sebastian-silaghi/Analog-Interface-for-ADC-input/Documentation/Documentation.pdf

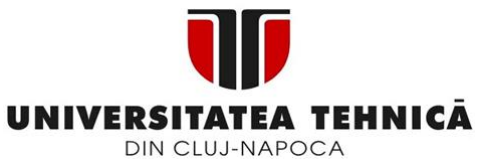
[picture p1: figure]

# SYSTEMS WITH ANALOG INTEGRATED CIRCUITS PROJECT

# ANALOG INTERFACE

## Professor: Alessandro Battigelli

## Student: Silaghi Sebastian

## Year: III

## Specialization: Applied Electronics

## TABLE OF CONTENT

## 1. Project theme

Design of an analog interface consisting of four cascaded stages: instrumentation amplifier made with three operational amplifiers with differential voltage input and voltage output (stage 1), an analog Tow-Thomas filter with voltage input and voltage output (stage 2), an amplifier with programmable gain (stage 3) and a precision double-alternating rectifier (stage 4).

The differential input signal is the voltage signal given by a sensor with amplitude in the range [261mV; 520mV], and the maximum frequency of the signal is considered the center frequency of the band-pass filter in the Tow-Thomas filter.

Stage 1 - Instrumentation amplifier: linear gain 6 [V/V] with adjustment of the DC voltage at the output. The stage band should be higher than the maximum frequency of the input signal and the output signal should be undistorted.

Stage 2 - Analog Tow-Thomas filter: unity gain in the passband, minimum input impedance 1kΩ and quality factor 1. The center frequency of the bandpass filter and the Tow-Thomas filter band have the same frequency of 7kHz. The signal at the output of the filter should be undistorted.

Stage 3 - The programmable gain amplifier (PGA) operates as an inverting amplifier with switches outside the signal path for gain adjustment. The minimum gain of the stage is 1dB, and the maximum gain is 7dB with a resolution of 2dB in four steps. The minimum input impedance should be 1.5kΩ, and the output signal should be undistorted at the maximum frequency for both the minimum input amplitude and maximum gain of the stage, and for the maximum input amplitude and minimum gain of the stage.

Stage 4 – Double-phase precision rectifier: unity gain and it is desired to perform its function correctly at large signal.

For the design, the ADA4627 operational amplifier and the ADG1311 integrated circuit for switches were used.

## 2. Stages sizing

### 2.1 Stage 1 sizing

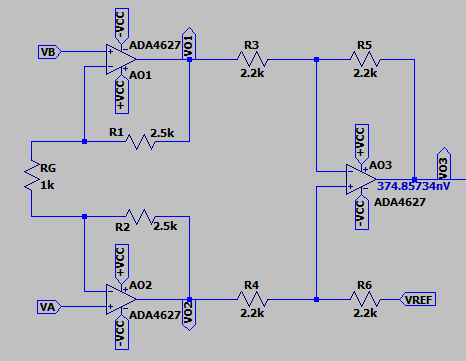
[picture p2: figure]

Figure 1. Instrumentation amplifier

This stage consists of 2 substages, each with a separate gain: AO1 and AO2 form the first substage with gain A1, and AO3 forms the second substage with gain A2.

For the first substage, both operational amplifiers AO1 and AO2 have negative feedback, therefore we have:

v1

+ = v1
− = vB
v2

+ = v2
− = vA

⇒ iRG =

vA−vB
RG

Also,
v02 − v01 = vR2 + vRG + vR1

v02 − v01 = iRG ⋅ R2 + iRG ⋅ RG + iRG ⋅ R1

R1 = R2 ⇒ v02 − v01 = iRG ⋅ (2R1 + RG

) (1)

Replacing iRG in relation (1) we get:

v02 − v01 = (1 +

2R1
RG

) (vA − vB)

So, we obtain the gain of the first substage A1= (1 +

2R1
RG

)

For the second substage, we use Millman`s theorem to find the potentials v3

+ and v 3
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
VREF
R6
1
R4

+

1
R6

AO3 also has negative feedback, thus:
v3

+ = v3
− and we consider R3 = R4 și R5= R6 then we get:

v03 =

R5
R3

### (v02 − v01) + VREF (2)

So, we obtain the gain of the second substage A2=

R5
R3

Replacing realtion (1) in (2) we have: v03 =

R5
R3

(1 +

2R1
RG ) (vA − vB) + VREF

The linear gain A of the entire stage will be the product of the individual gains of the two substages, which must be 6 V/V. We want the first substage to be the gain stage, and the second to be the differential stage with unity gain, therefore:

A = A1 ⋅ A2 = 6 ⇒

A1 = 6 [

V
V

]

A2 = 1 [

V
V

]

A2 = 1 ⇒

R5
R3

= 1 ⇒ R5 = R3

R3 = 2.2kΩ ⇒ R5 = 2.2kΩ

A1 = 6 ⇒

1 +

2R1
RG

= 6 ⇒ R1 =

5
2

RG

RG = 1kΩ ⇒ R5 = 2.5kΩ

From .op analysis ⇒ v03 = Vos= 585µV ⇒ VREF we set it to 585µV for the output DC offset voltage adjustment. In figure 1 that voltage of 375nV represents the offset voltage after compensation.

### 2.2 Stage 2 sizing

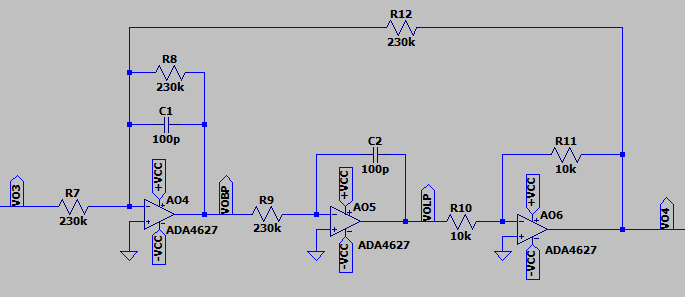
[picture p3: figure]

Figure 2. Tow-Thomas filter

Transfer function general form: H(s) = H0

ωp

2

s

2+s⋅

ωp
Q

+ωp

2

Bandpass gain: H0 =

R12
R7

Cutoff angular frequency: ωp =

1
√R9R12C1C2

Quality factor: Q = R8√
C1
C2

⋅

1
R9R12

H0 = 1 ⇒ R12 = R7 (3)

For calculation simplicity, we consider R12 = R9 (4) and C1 = C2 (5) and we get:

wp =

1
R9C1
(6) , Q =

R8
R9

(7)

Q = 1 ⇒ from (7) that R8 = R9
(8)

From (6) ⇒ the cutoff frequency of the filter is fp =

1
2πR9C1

Also, fp = BW ⋅ Q , where BW is the band of the filter, and we get the equality:

1
2πR9C1

= BW ⋅ Q

We know that BW = 7kHz and Q = 1 ⇒

1
2πR9C1

= 7kHz ⇒ R9C1 = 23 ⋅ 10⁻⁶

We choose C1= 100pF ⇒ R9 = 230kΩ and according to (4), (5), (8) and (3) ⇒ R12 = 230kΩ , C2= 100pF, R8 = 230kΩ, respectively R7 = 230kΩ

We want the inverting amplifier AO6 to have unity gain in order to maintain the total gain of the filter to 1. The gain of the amplifier AO6 is |A| =

R11
R10

|A| = 1 ⇒ R11 = R10

Let R11 = 10kΩ ⇒ R10 = 10kΩ

### 2.3 Stage 3 sizing

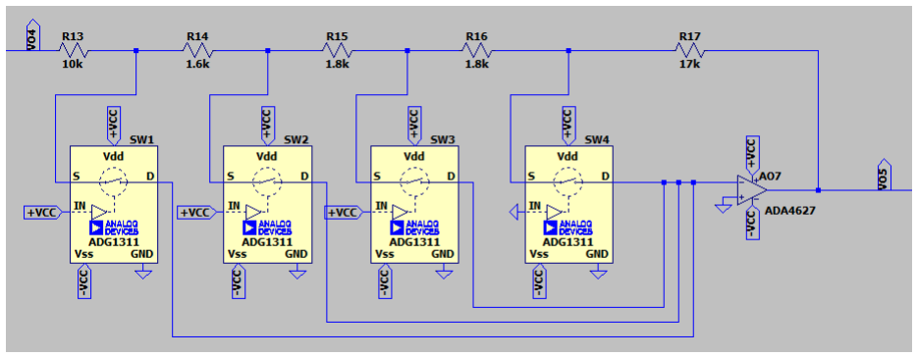
[picture p4: figure]

Figure 3. Programmable gain amplifier (PGA)

This PGA can generate 4 different gains (A1, A2, A3, A4) from 1dB to 7dB, in four steps,

so we have a 2dB step between each gain, where the overall gain is|A| =

RF
RG

|A1

| = 1 dB = 1.12 V/V

|A2

| = 3 dB = 1.41 V/V

|A3

| = 5 dB = 1.78 V/V

|A4

| = 7 dB = 2.24 V/V

The switches made with the ADG1311 integrated circuit operate in complementary logic, so a switch will be active if a logic 0 (GND) is applied to the IN terminal and will be inactive if a logic 1 (+VCC) is applied to the IN terminal.

SW1 | SW2 | SW3 | SW4 | RF | RG | |A|
0 | 1 | 1 | 1 | R17 + R16 + R15 + R14 | R13 | A4
1 | 0 | 1 | 1 | R17 + R16 + R15 | R13 + R14 | A3
1 | 1 | 0 | 1 | R17 + R16 | R13 + R14 + R15 | A2
1 | 1 | 1 | 0 | R17 | R13 + R14 + R15 + R16 | A1

R17
R13 + R14 + R15 + R16

= 1.12 (9)

R16 + R17
R13 + R14 + R15

= 1.41 (10)

R15 + R16 + R17
R13 + R14

= 1.78 (11)

R14 + R15 + R16 + R17
R13

= 2.24 (12)

(12) – (11) ⇒ R14 = 0.16R13 (13)
(11) – (10) ⇒ R15 = 0.18R13 (14)
(10) – (9) ⇒ R16 = 0.18R13 (15)

From (9), (13), (14), (15) ⇒ R17 = 1.7R13 (16)

Let R13 = 10kΩ . From (13), (14), (15), (16)

R17 = 17kΩ

R16 = 1.8kΩ

R15 = 1.8kΩ

R14 = 1.6kΩ

### 2.4. Stage 4 sizing

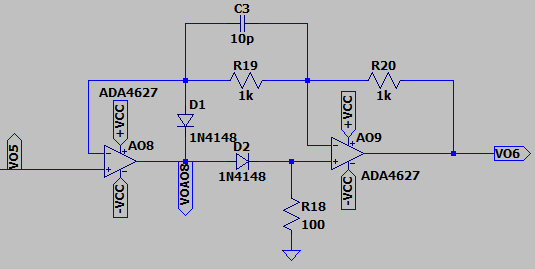
[picture p5: figure]

Figure 4. Precision positive full-wave rectifier

We assume for both cases I and II that the two diodes D1 and D2 are OFF. We will consider
vin = vO5 and vout = vO6

I. vin < 0

v8

+ = vin < 0
v9
+ = 0 | ⇒ v8 +
- v8

− < 0 ⇒ VoAO8 ↘ -Vcc

NF at AO9 ⇒ v9

+ = v9
− = 0 ⇒ v8

− = 0

VA1 = 0 | ⇒ D1 ON

VK1 = VoAO8 = −Vcc

VA2 = VoAO8 = −Vcc ⇒ D2 OFF

VK2 = 0

For this case when vin < 0, the diodes are actually D1 ON and D2 OFF, not as we initially assumed. Next, we analyze the circuit in this configuration. We consider the diode in conduction as a voltage source of 0.7V.

v8

+ = vin < 0

v8

− = vD + VoAO8

NF at AO8 ⇒ v8

+= v8
− (17) ⇒ vin = vD + VoAO8 ⇒ VoAO8 = vin − vD

v9

+ = 0

v9

− =

v8

−
R19

+

vout
R20
1
R19

+

1
R20

NF at AO9 ⇒ v9

+ = v9
− ⇒

v8

−

R19

+

vout
R20

= 0 ⇒ vout = −

R20
R19

vin

II. vin > 0

v8

+ = vin > 0 ⇒ v8 + − v8
− > 0 ⇒ VoAO8 ↗ +Vcc
v8

− = 0

VA1 = 0 | ⇒ D1 OFF

VK1 = VoAO8 = +Vcc

VA2 = VoAO8 = +Vcc ⇒ D2 ON

VK2 = 0

For this case when vin < 0, the diodes are actually D1 OFF and D2 ON, not as we initially assumed. Next, we analyze the circuit in this configuration. We consider the diode in conduction as a voltage source of 0.7V.

v8

+ = vin

v9

+ = VoAO8 − vD (18)

v9

− =

v8

−
R19

+

vout
R20
1
R19

+

1
R20

(19)

NF at AO9 ⇒ v9

+ = v9
− (20) ⇒ NF at AO8 through AO9 ⇒ v8

+ = v8
− = vin (21) (voltage
follower) ⇒ v9

+ = vin (22)

From (18), (22) ⇒ vin = VoAO8 − vD ⇒ VoAO8 = vin + vD

From (19), (21), (22) ⇒ vin =

vin
R19

+

vout
R20
1
R19

+

1
R20

⇒ vout = vvin

Concl.: vout = | vin ∈ [vD + VoAO8

, VoAO8 − vD]

The gain

R20
R19

for negative alternation of the input signal must be 1, therefore

R20 = R19. IF we let R20 = 1kΩ ⇒ R19 = 1kΩ.

Resistor R18 influences the rectified output voltage swing on the positive alternation. According to the amplifier datasheet, for a 100Ω load, the output voltage swing V_oAO8_high is +Vcc-1.3V, and V_oAO8_low is -Vcc+1.3V . In this stage configuration, if R18 is 100Ω, the rectifier output oscillates. The more the resistance R18 decreases, the more the oscillations are damped, but already below 60Ω we do not get a good output voltage swing, and the rectification on the positive alternation is limited below the amplitude of the input signal. Thus, a possible solution would be a frequency compensation using a capacitor on the feedback of AO8 to move the parasitic poles that create oscillations further in frequency. The load remains at 100Ω and the capacitor C3 is 10pF. The value of C3 is experimentally chosen so that the rectification is correct without oscillations in the transient simulation.

In order to keep the output voltage of AO8 out of saturation, vin + vD when vin > 0, respectively vin − vD when vin < 0 must not exceed the output voltage swing VoAO8_high, respectiv VoAO8_low.

−

R20
R19
vin | dacă vin < 0
vin | dacă vin > 0

## 3. Circuit simulations

### 3.1 Stage 1 simulations

### 3.1.1 DCOP simulation

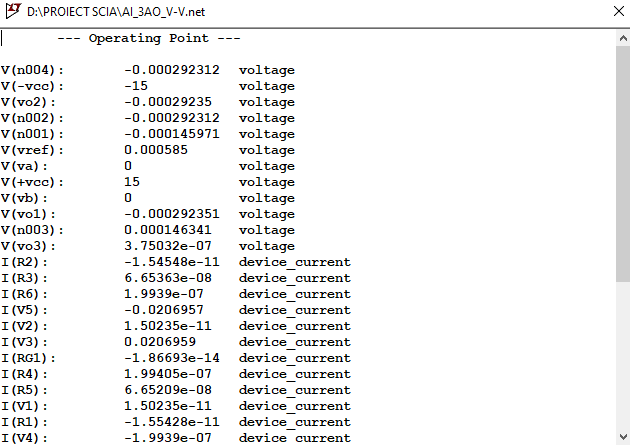
[picture p6: figure]

Figure 5. DC operating point

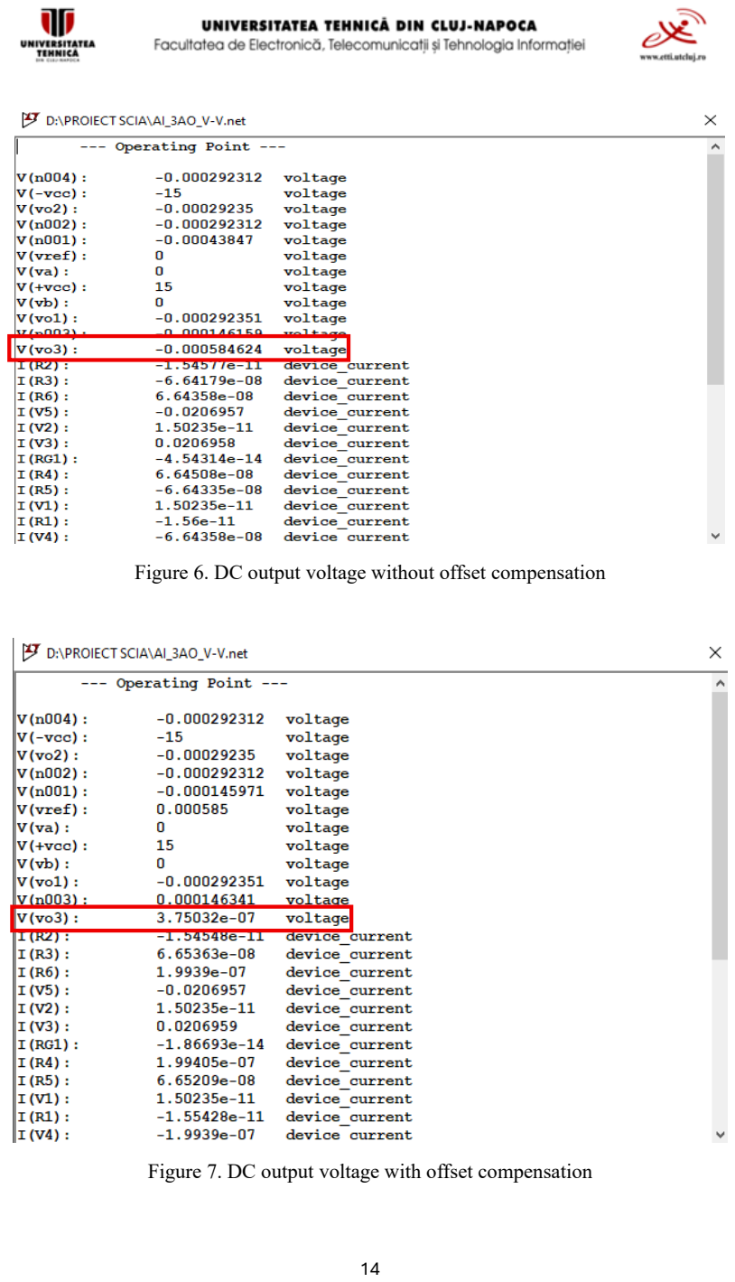
[picture p7: page 14]

Figure 6. DC output voltage without offset compensation

Figure 7. DC output voltage with offset compensation

### 3.1.2 AC simulations

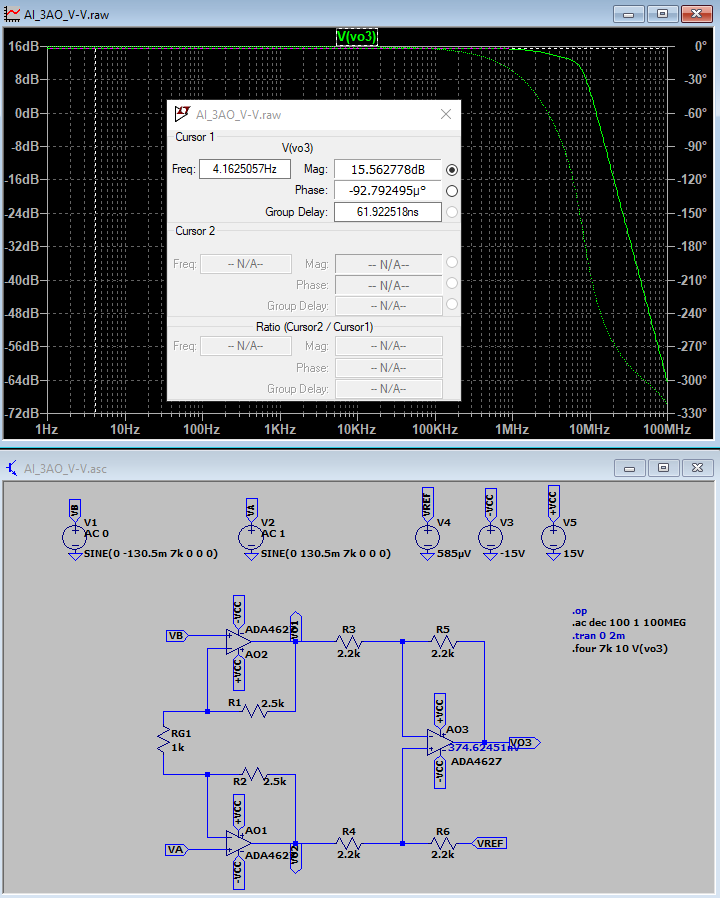
[picture p8: figure]

Figure 8. Low frequency gain

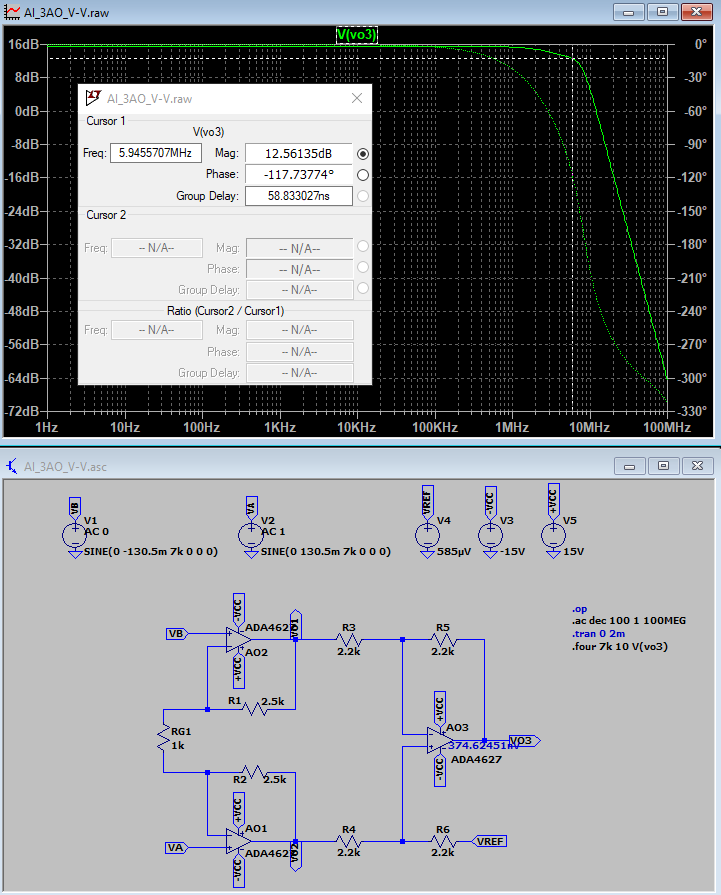
[picture p9: figure]

Figure 9. Band at -3dB

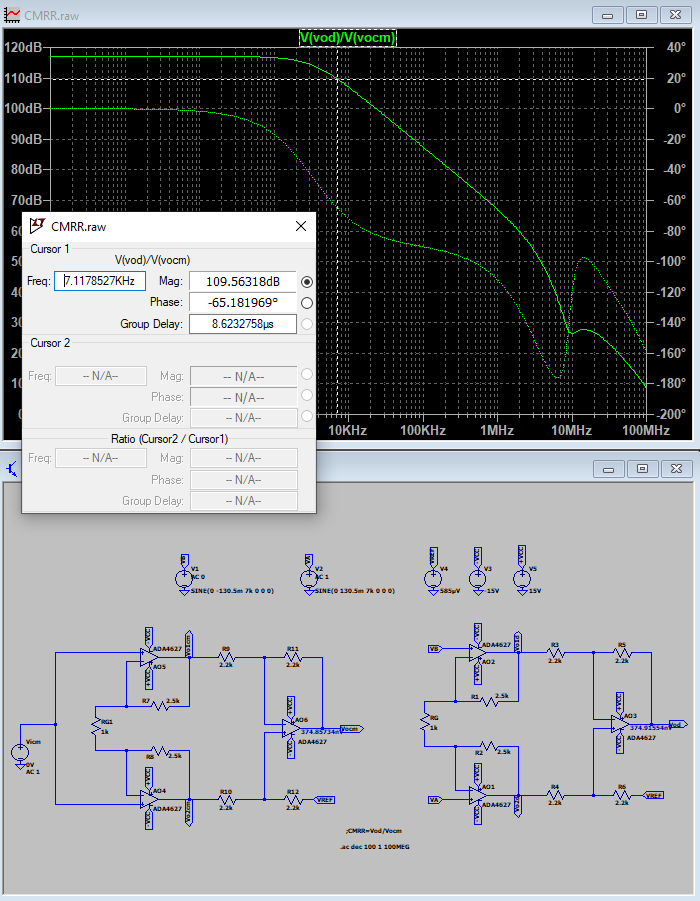
[picture p10: figure]

Figure 10. CMRR

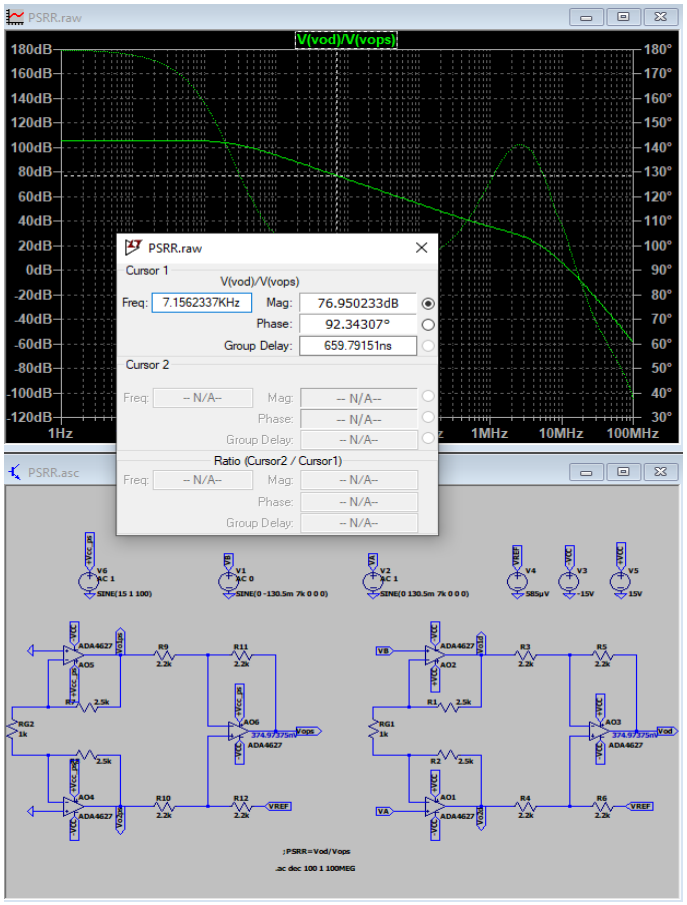
[picture p11: figure]

Figure 11. PSRR

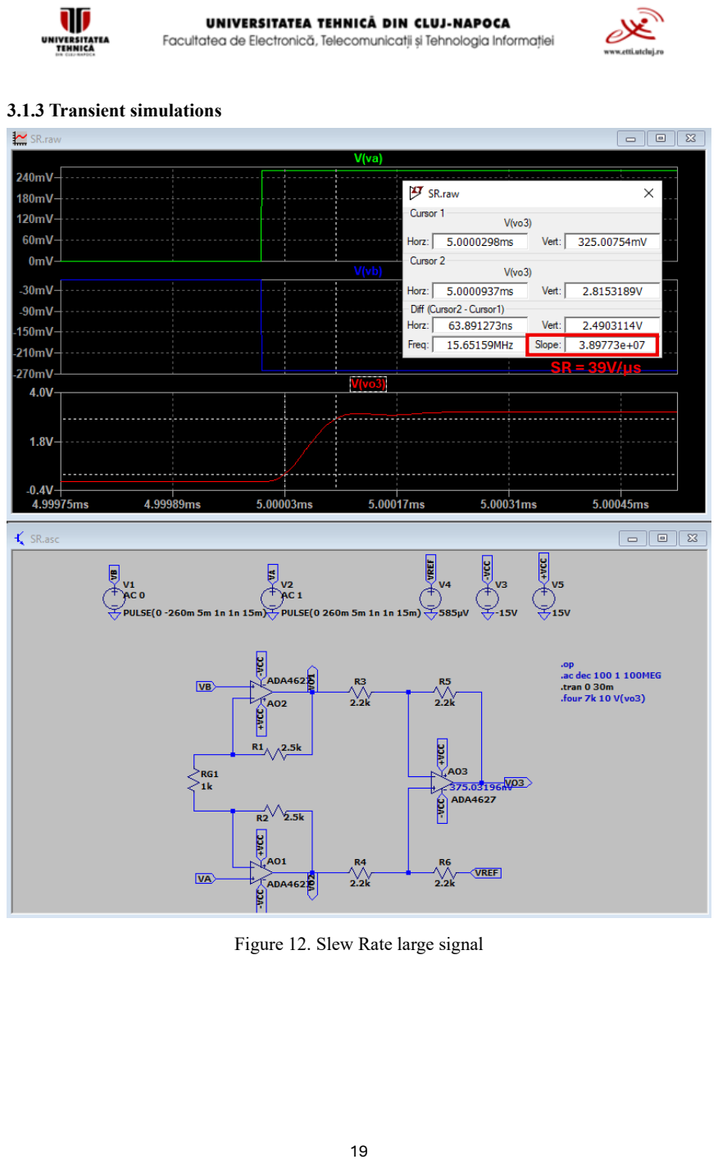
[picture p12: page 19]

### 3.1.3 Transient simulations

Figure 12. Slew Rate large signal

### SR = 39V/µs

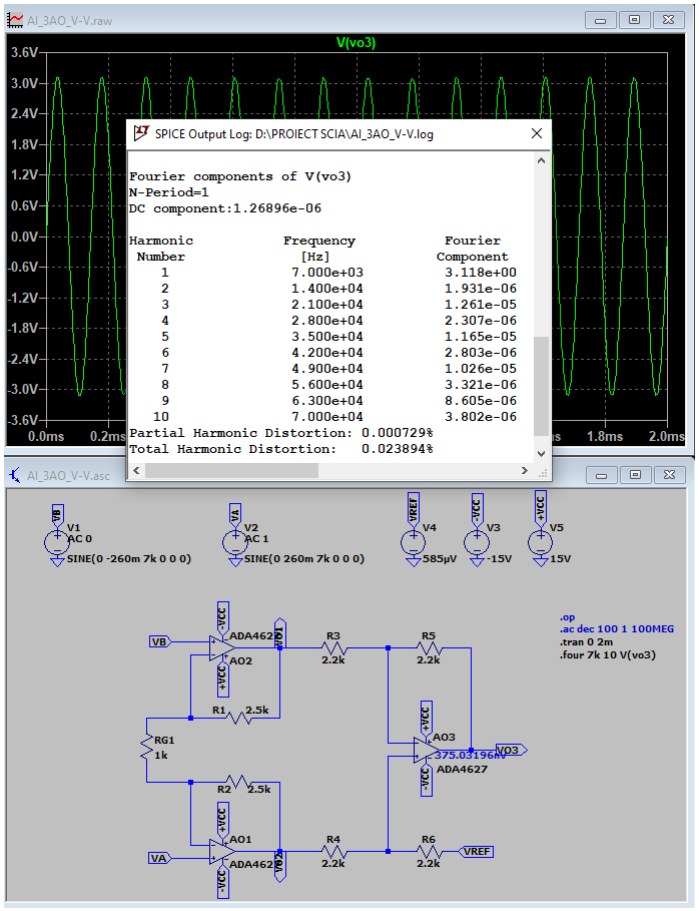
[picture p13: figure]

Figure 13. THD large signal

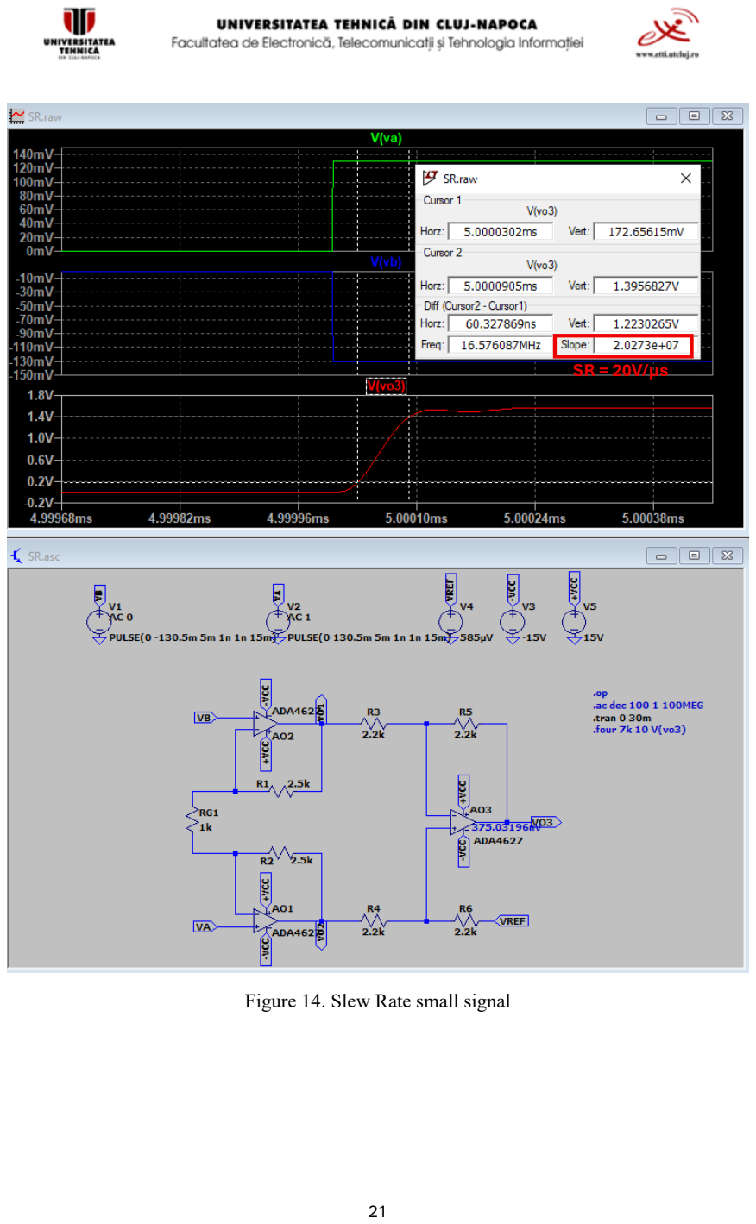
[picture p14: page 21]

Figure 14. Slew Rate small signal

### SR = 20V/µs

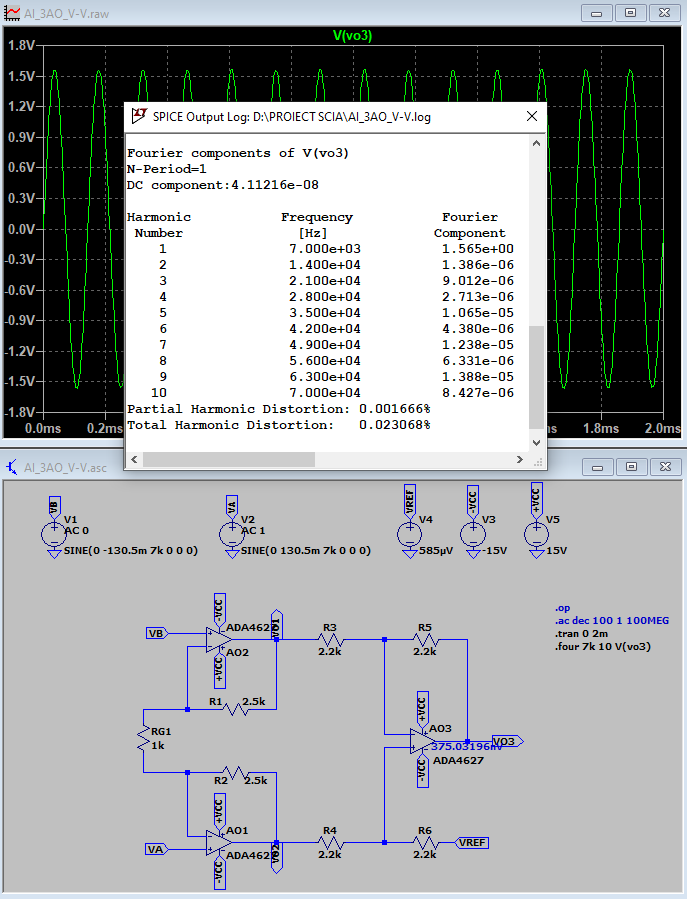
[picture p15: figure]

Figure 15. THD small signal

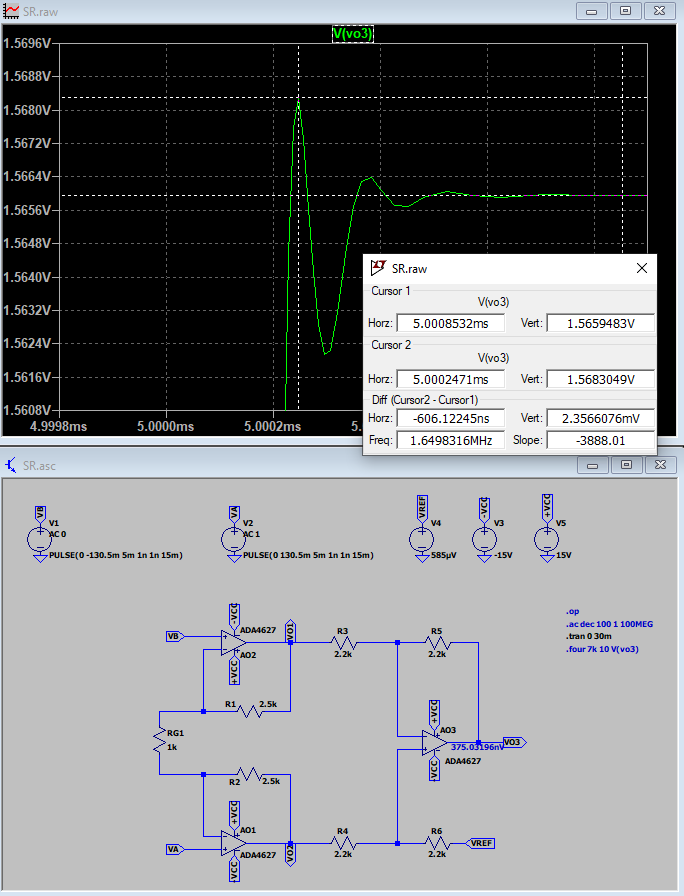
[picture p16: figure]

Figure 16. Small step response

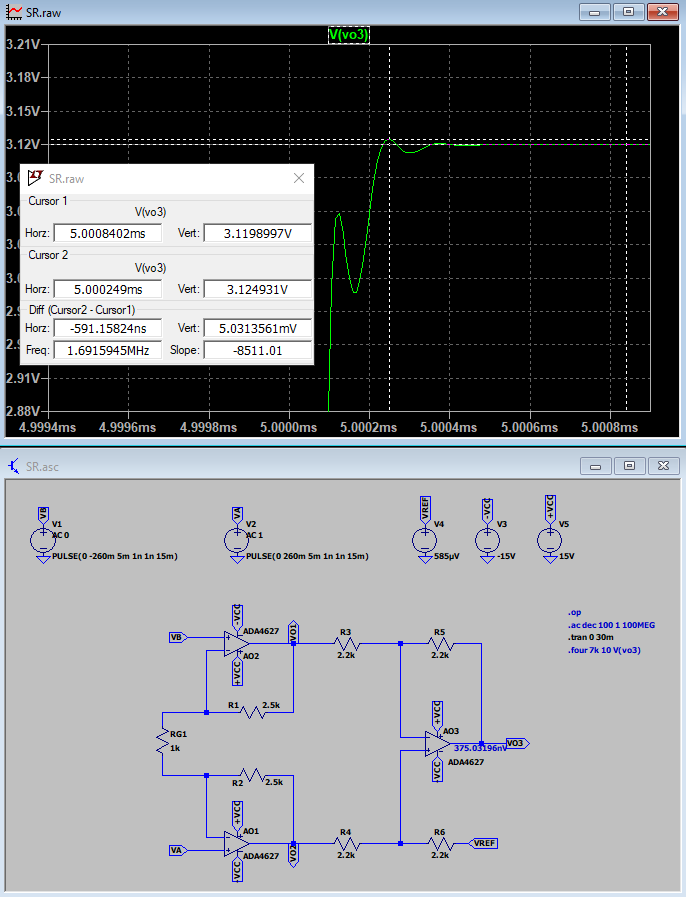
[picture p17: figure]

Figure 17. Large step response

### 3.2 Stage 2 simulations

### 3.2.1 DCOP simulations

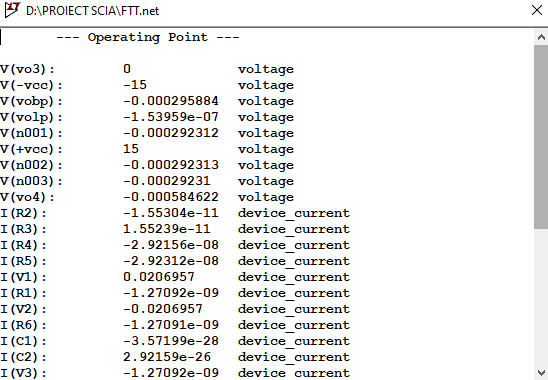
[picture p18: figure]

Figure 18. DC operating point

### 3.2.2 AC simulations

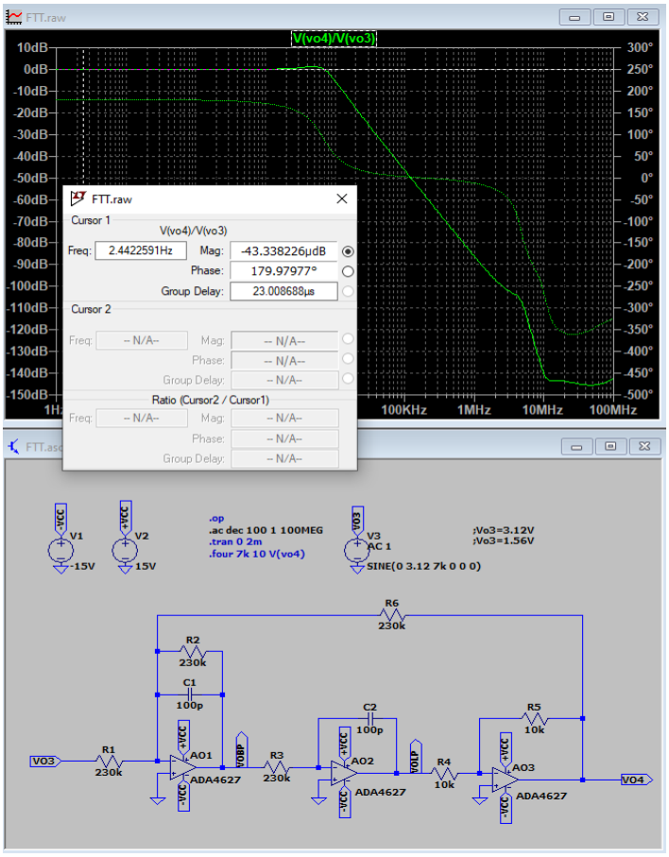
[picture p19: figure]

Figure 19. Filter gain

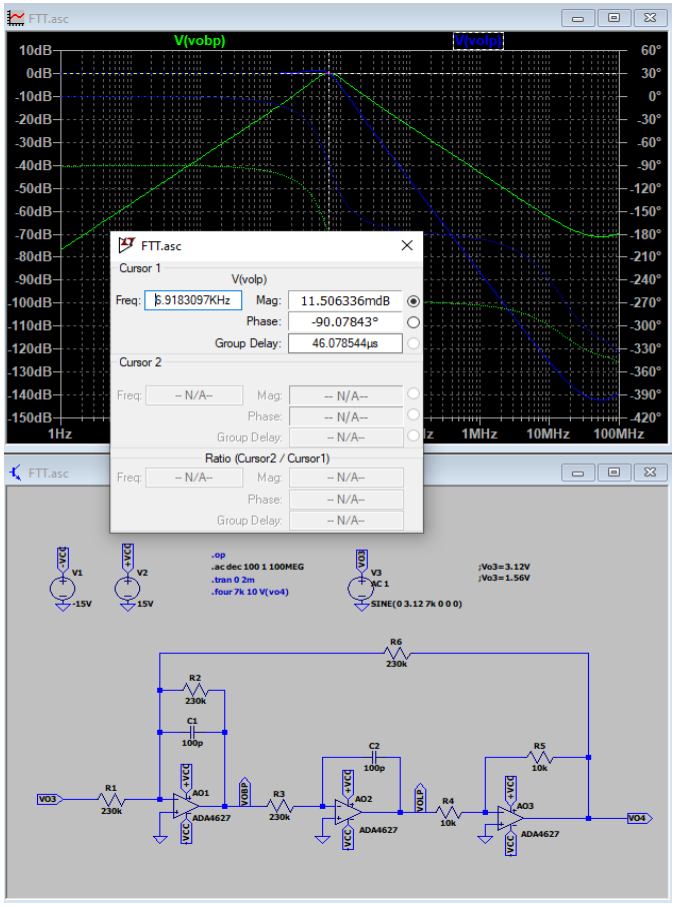
[picture p20: figure]

Figure 20. Filter band and bandpass gain (-90deg LPF)

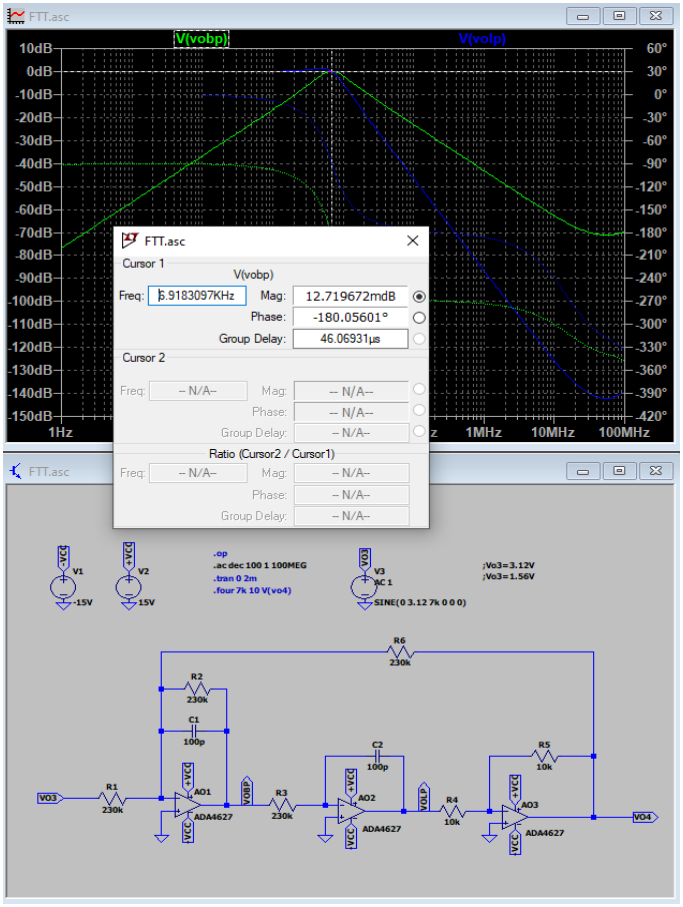
[picture p21: figure]

Figure 21. Filter band and bandpass gain (-180deg BPF)

### 3.2.3 Transient simulations

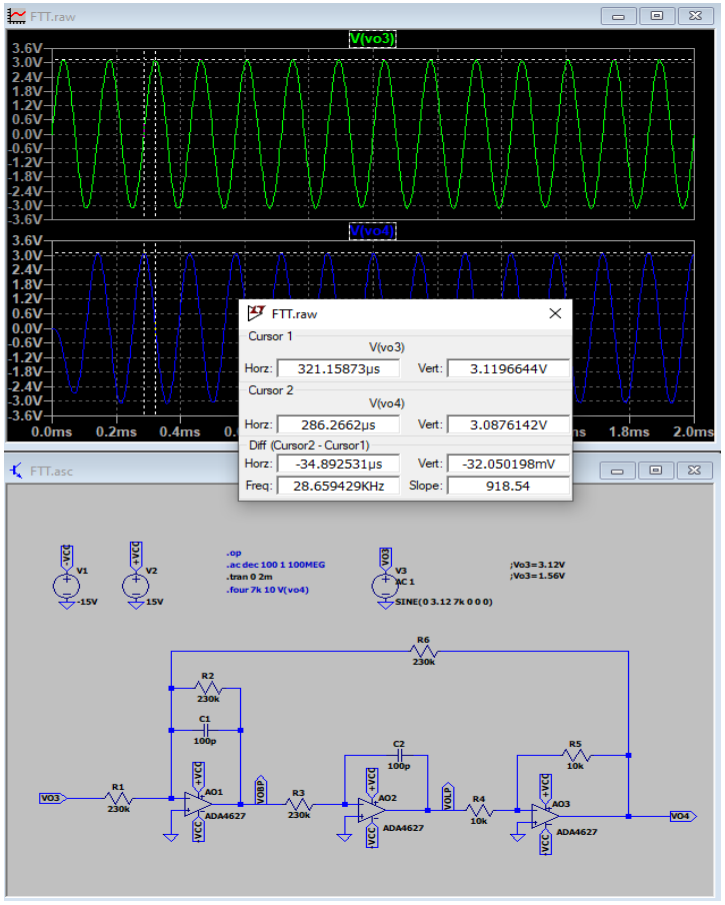
[picture p22: figure]

Figure 22. Large signal linearity (v̂04 = H0 ⋅ v̂03 at fmax = 7kHz)

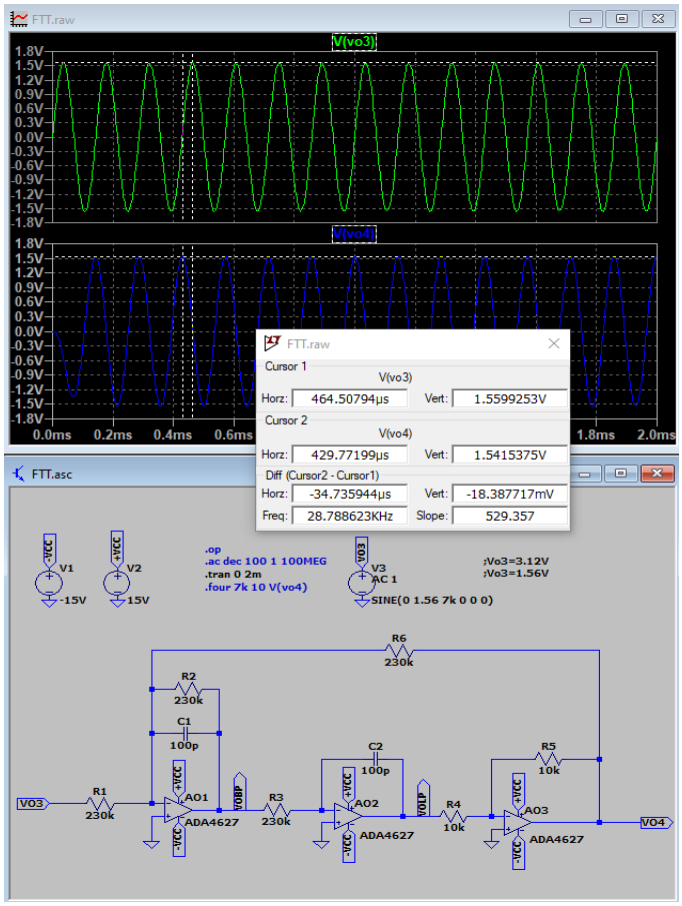
[picture p23: figure]

Figure 23. Small signal linearity (v̂04 = H0 ⋅ v̂03 at fmax = 7kHz)

### 3.3 Stage 3 simulations

### 3.3.1 DCOP simulations

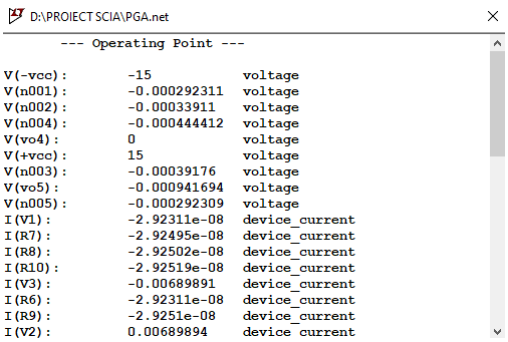
[picture p24: figure]

Figure 24. DC operating point

### 3.3.2 AC simulations

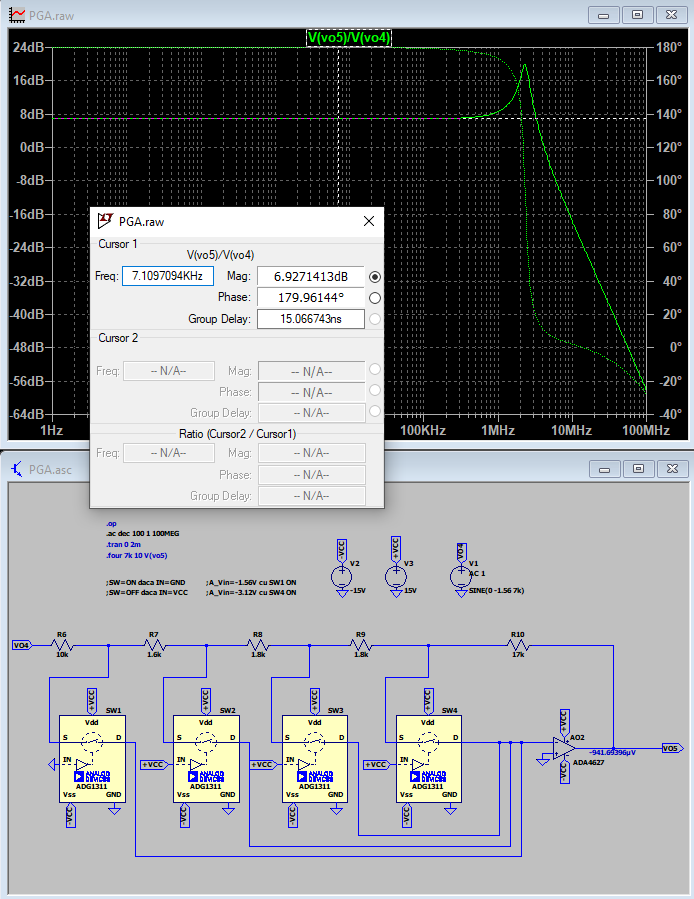
[picture p25: figure]

Figure 25. 7dB gain

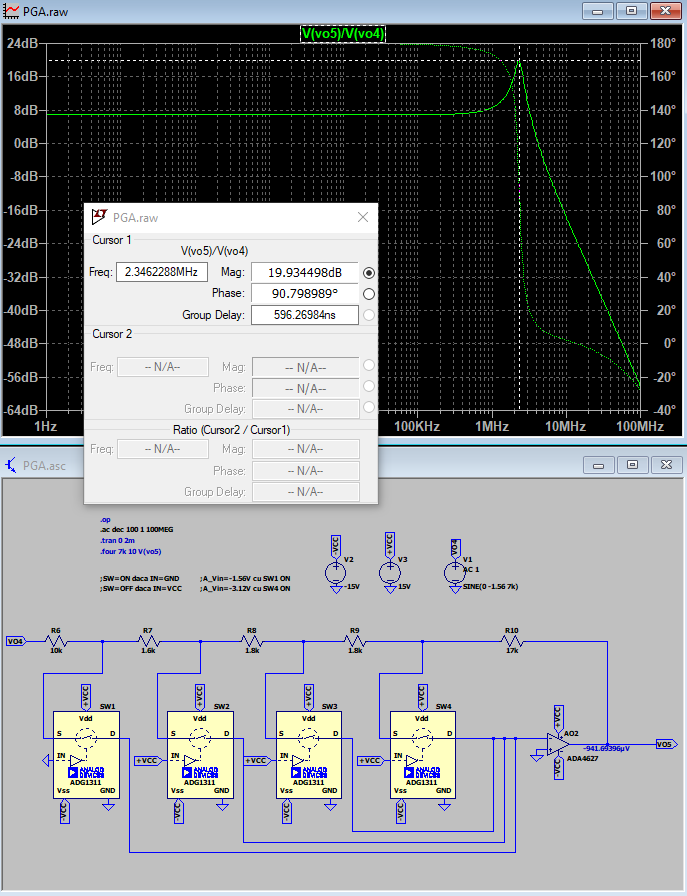
[picture p26: figure]

Figure 26. Bandwidth for 7dB gain

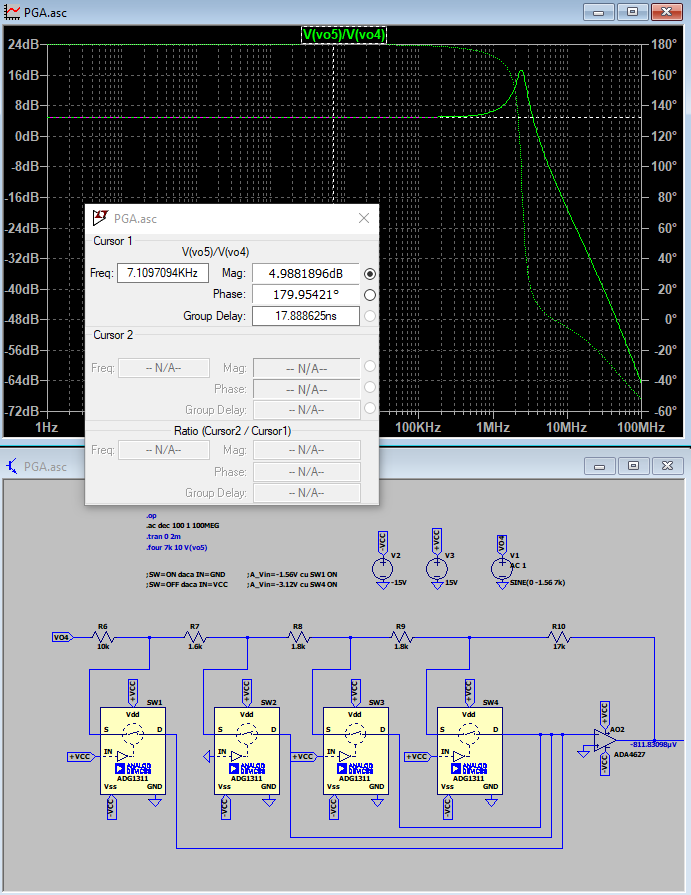
[picture p27: figure]

Figure 27. 5dB gain

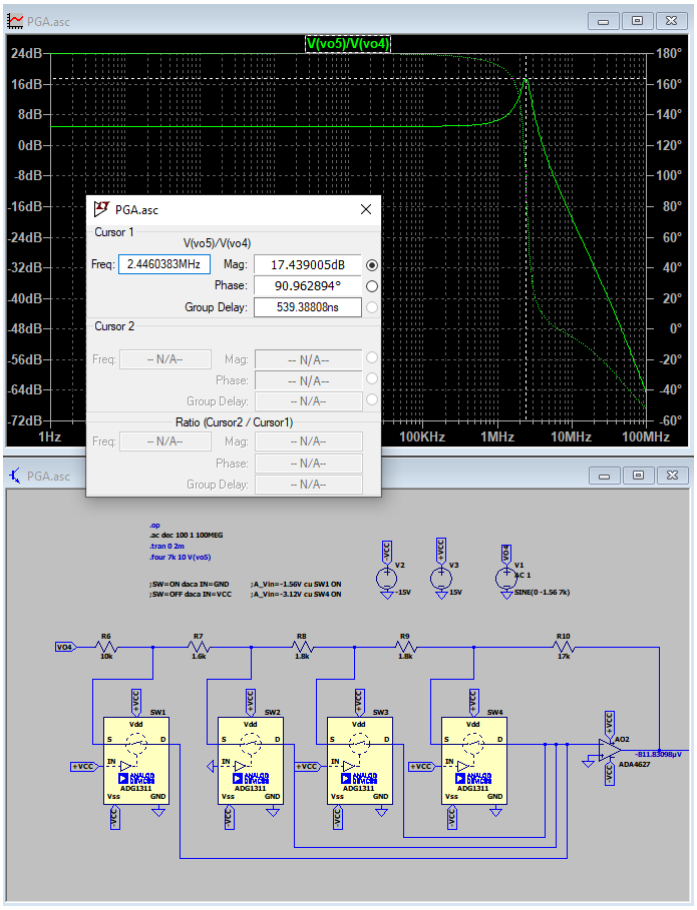
[picture p28: figure]

Figure 28. Bandwidth for 5dB gain

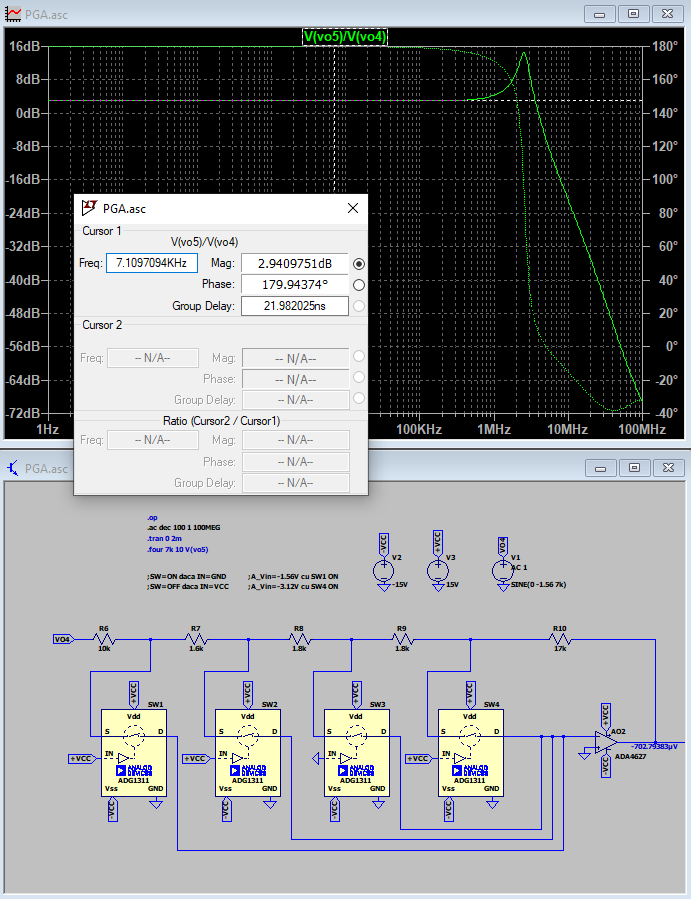
[picture p29: figure]

Figure 29. 3dB gain

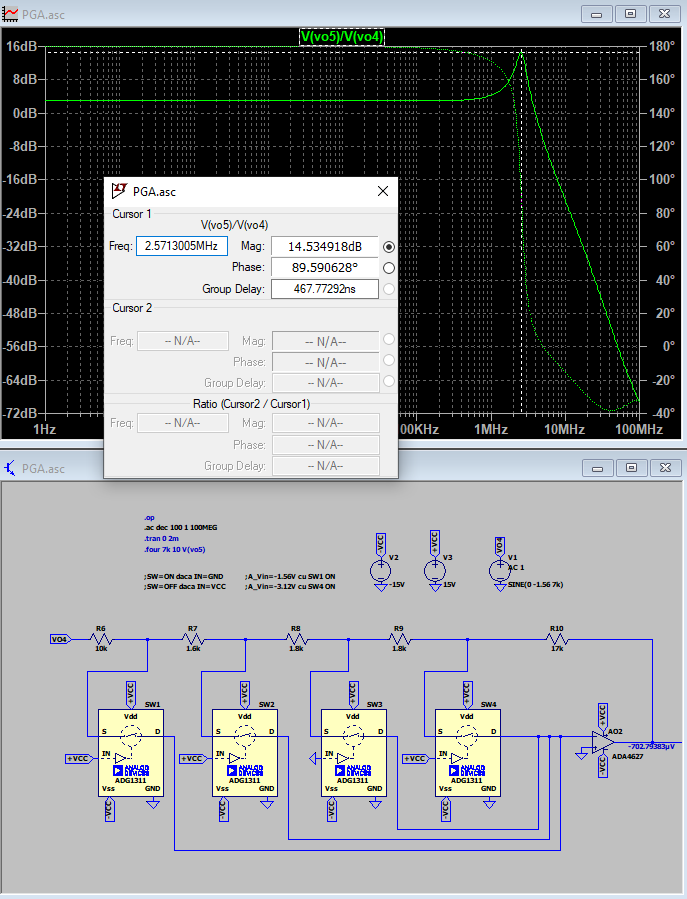
[picture p30: figure]

Figure 30. Bandwidth for 3dB gain

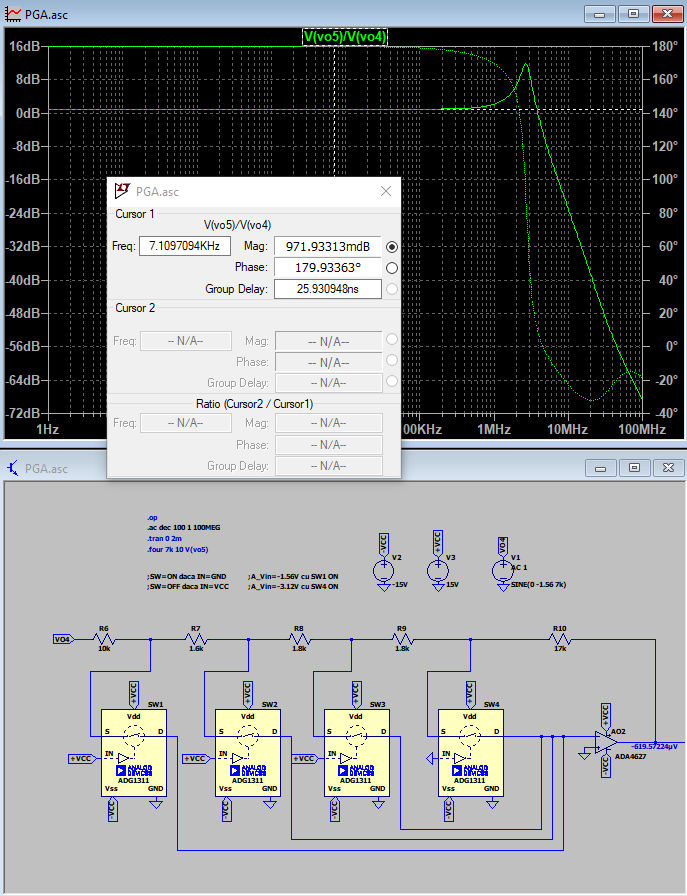
[picture p31: figure]

Figure 31. 1dB gain

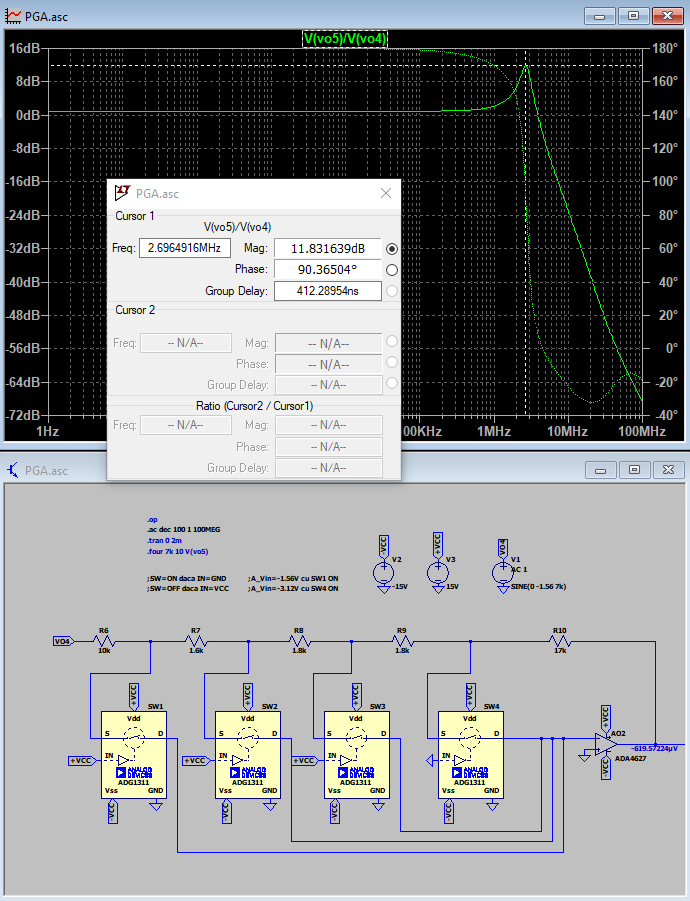
[picture p32: figure]

Figure 32. Bandwidth for 1dB gain

### 3.3.3 Transient simulations

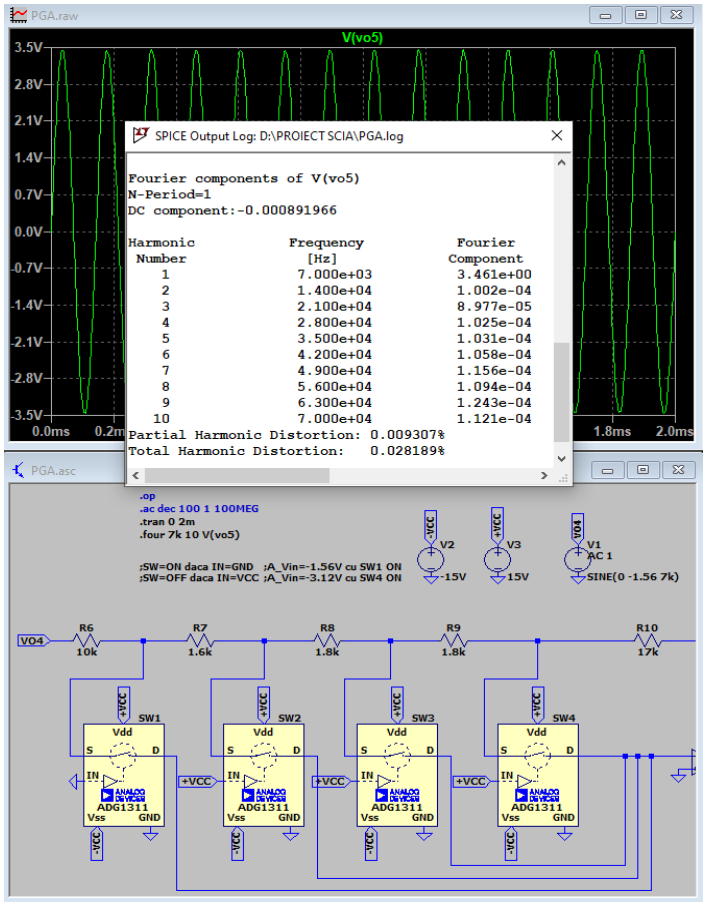
[picture p33: figure]

Figure 33. THD (small signal and maximum PGA gain)

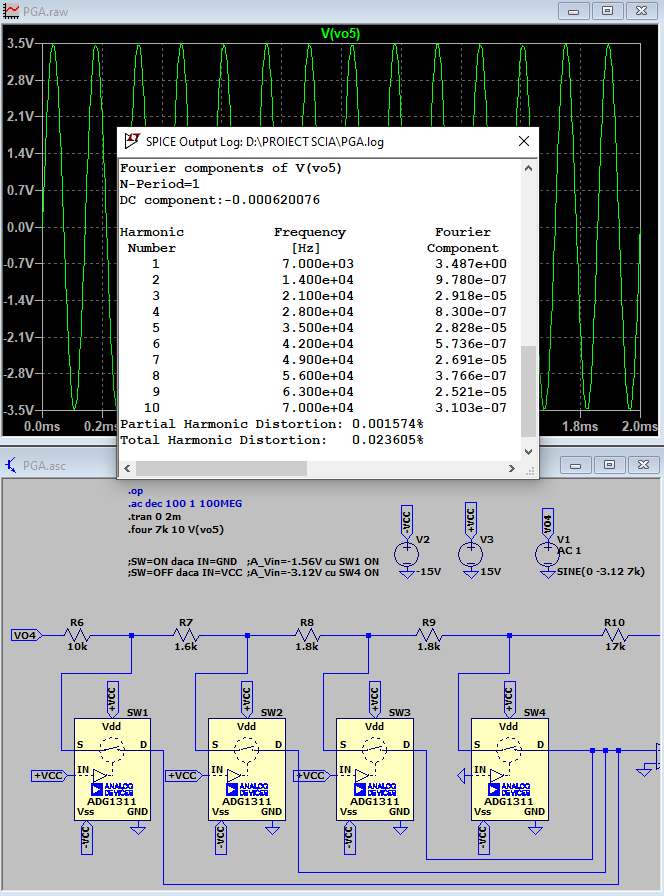
[picture p34: figure]

Figure 34. THD (large signal and minimum PGA gain)

### 3.4 Stage 4 simulations

### 3.4.1 DCOP simulations

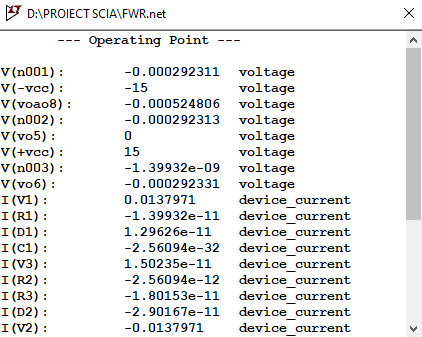
[picture p35: figure]

Figure 35. DC operating point

### 3.4.2 Transient simulations

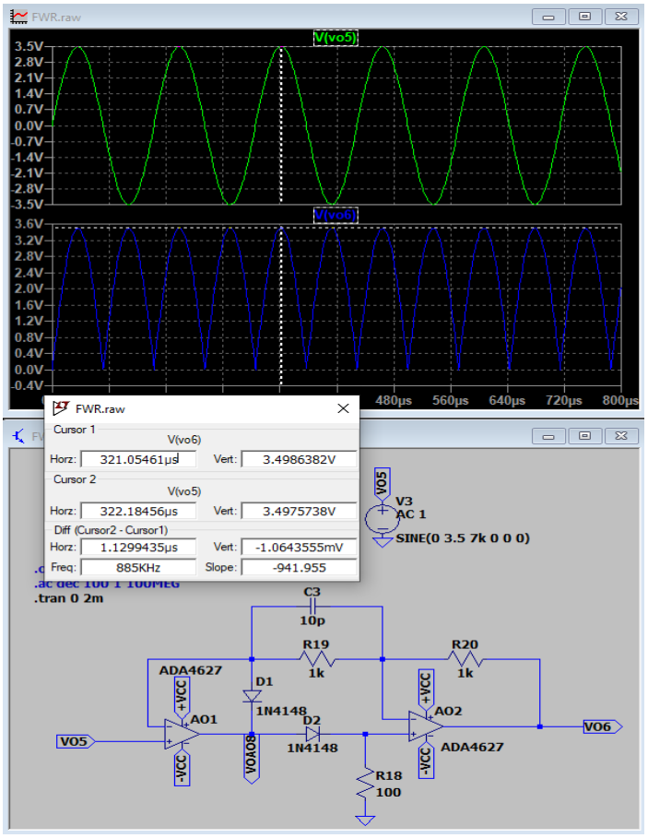
[picture p36: figure]

Figure 36. Circuit function

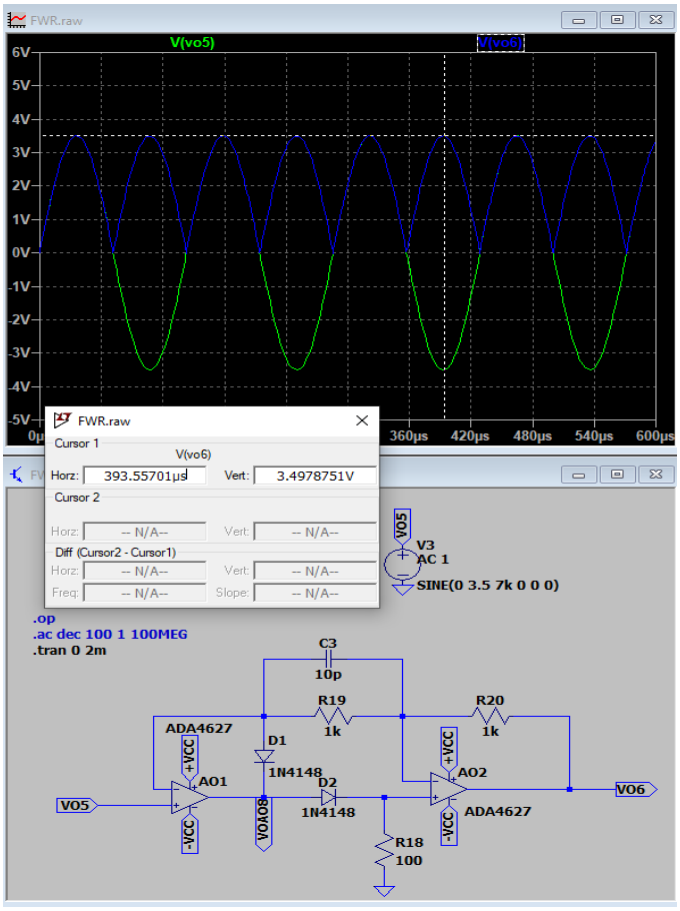
[picture p37: figure]

Figure 37. Circuit function

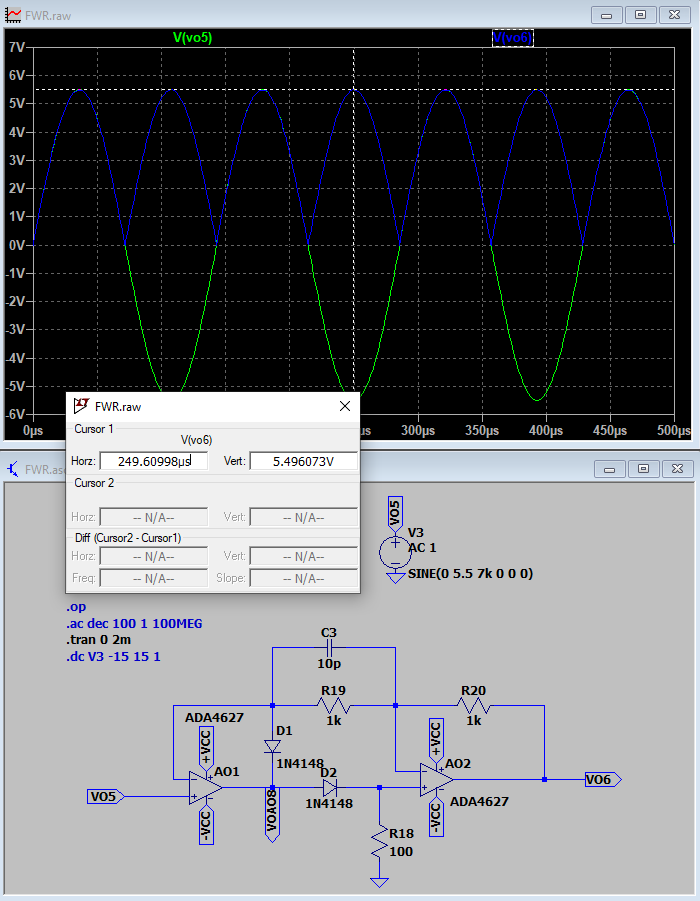
[picture p38: figure]

Figure 38. 5.5V maximum “positive” input signal amplitude

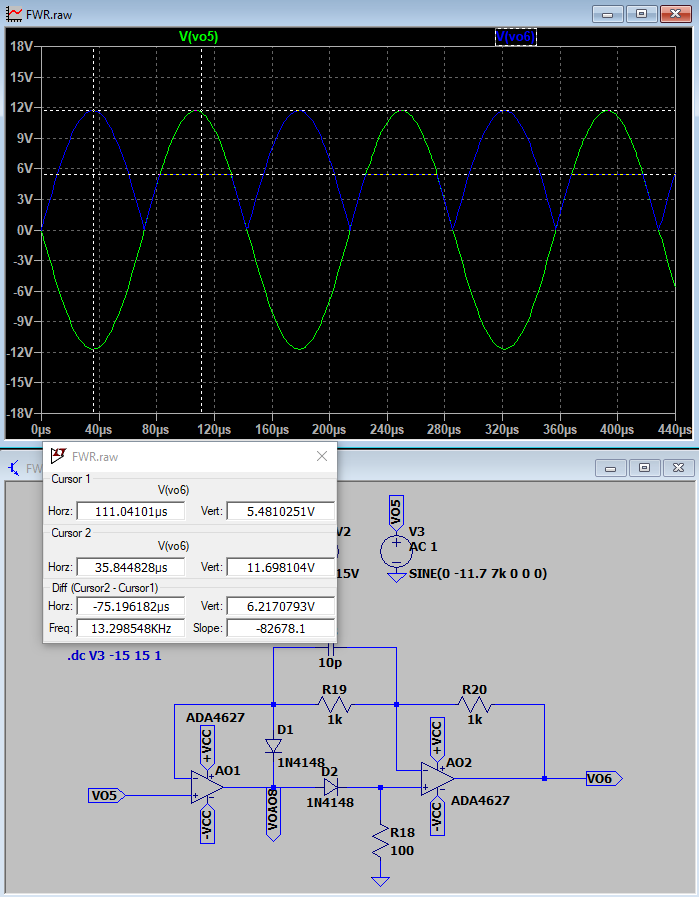
[picture p39: figure]

Figure 39. -11.7V maximum “negative” input signal amplitude

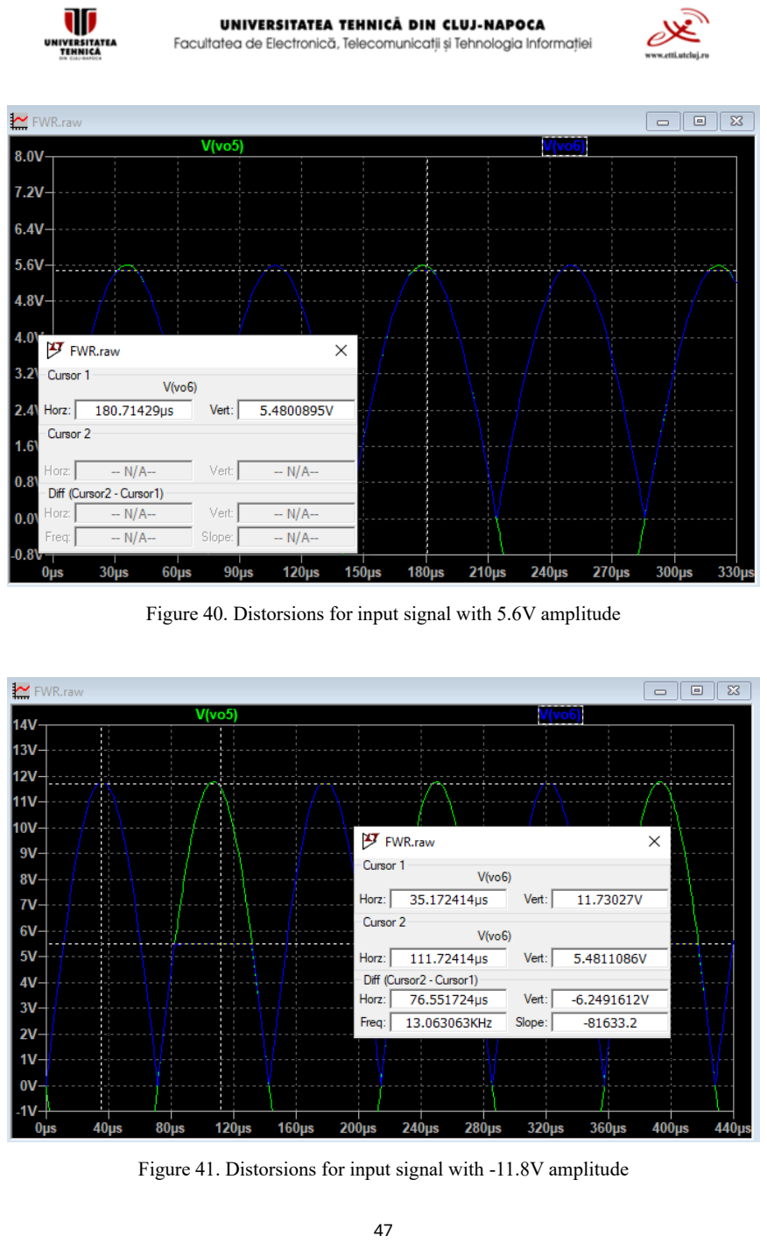
[picture p40: page 47]

Figure 40. Distorsions for input signal with 5.6V amplitude

Figure 41. Distorsions for input signal with -11.8V amplitude

According to the transient simulations in figures 40 and 41, the maximum input voltage range for each alternation emerges. Rectification on the positive alternation is done without distortion for amplitudes up to 5.5 V. Rectification on the negative alternation is done without distortion for amplitudes down to -11.7 V, but causes distortion of the positive alternation. Therefore, for correct rectification without any distortions, the maximum amplitude of the input signal must not exceed 5.5V (11 Vpp).

Please note: All these limitations are set for a 100Ω load at the VOAO8 output.

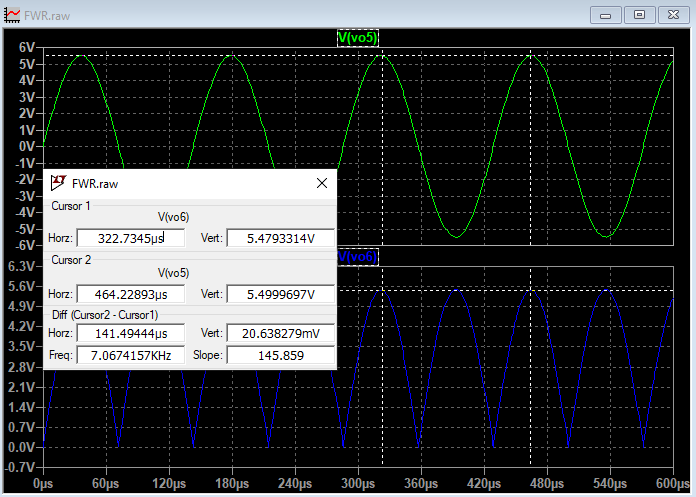
[picture p41: figure]

Figure 42. Maximum input voltage amplitude for no distorsions to occur

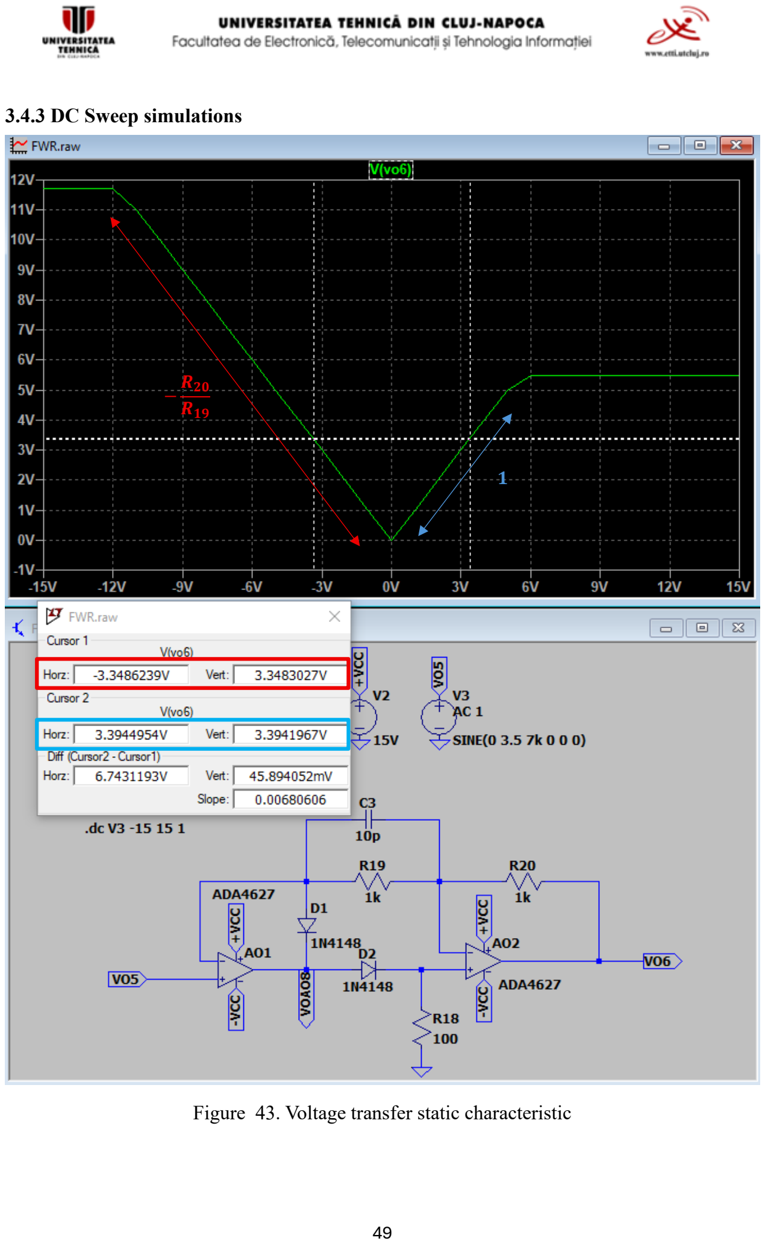
[picture p42: page 49]

### 3.4.3 DC Sweep simulations

Figure 43. Voltage transfer static characteristic

−

R20

R19

1

## 4. Practical implementation

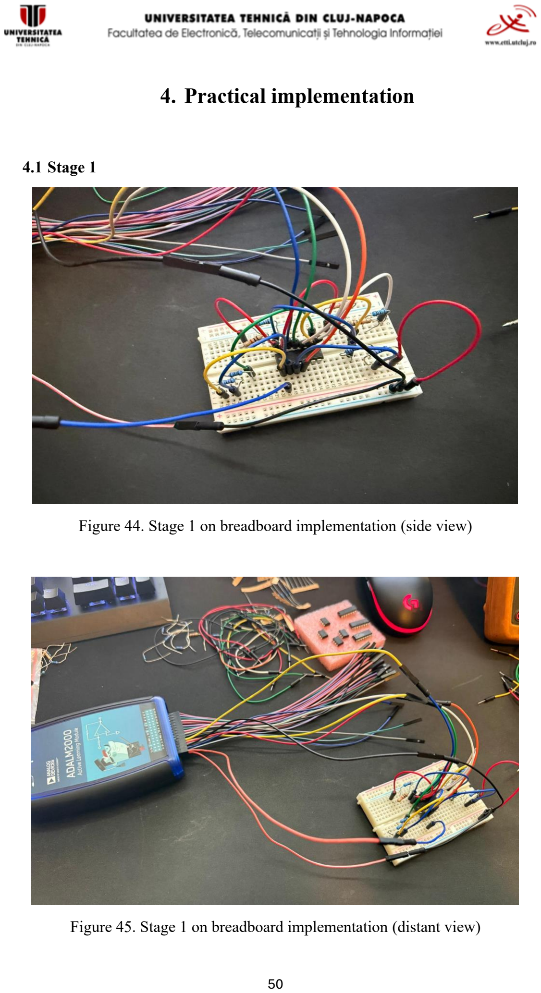
[picture p43: page 50]

### 4.1 Stage 1

Figure 44. Stage 1 on breadboard implementation (side view)

Figure 45. Stage 1 on breadboard implementation (distant view)

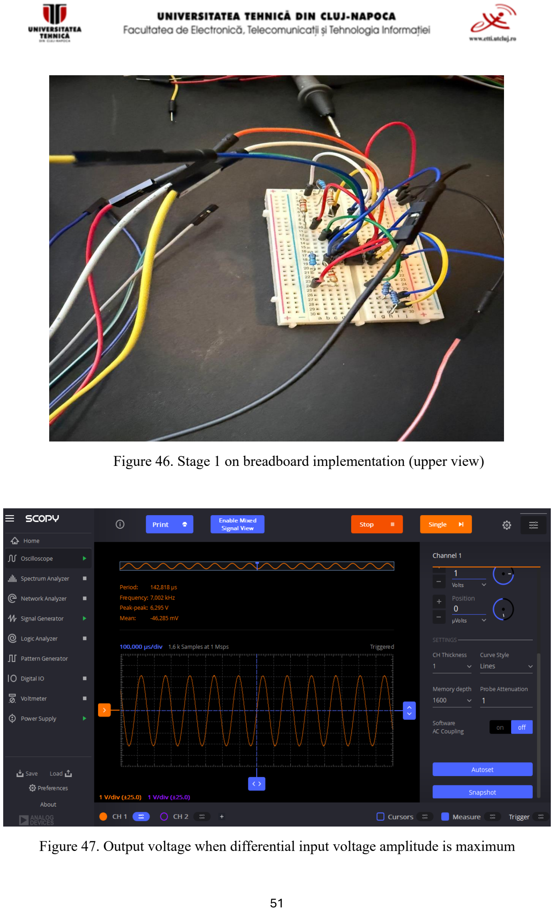
[picture p44: page 51]

Figure 46. Stage 1 on breadboard implementation (upper view)

Figure 47. Output voltage when differential input voltage amplitude is maximum

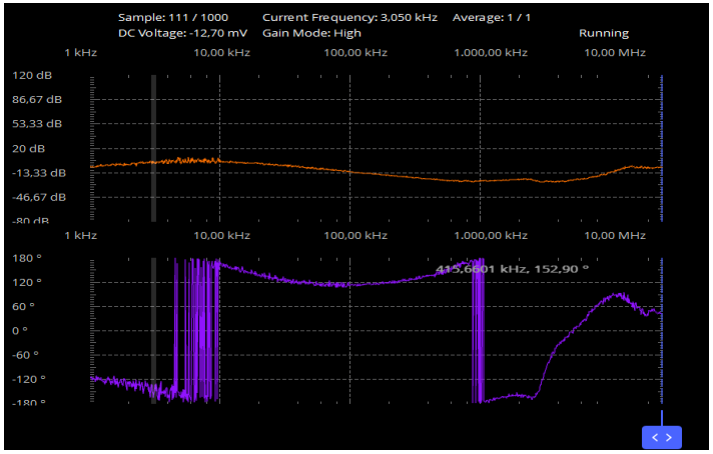
[picture p45: figure]

Figure 48. Bode characteristics

Because in LTSpice the circuit was simulated with a high-precision and high-speed ADA4627 operational amplifier and a different power supply, and for the practical implementation of the same circuit a much slower and much less precise operational amplifier OP482 was used, it does not behave as we would expect, as can be seen in Figure 48. However, a gain of approximately 15dB at a frequency of 7kHz is obtained, no parameters obtained in LTSpice can be extracted from here because we did not obtain a good frequency characteristic.

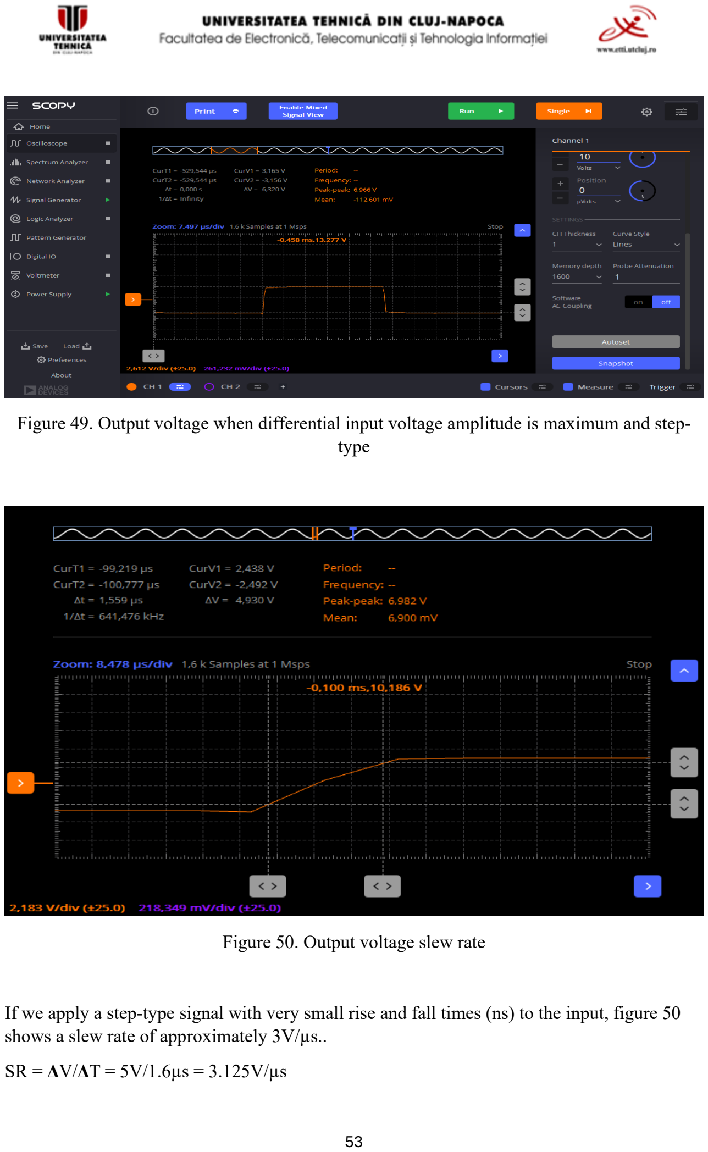
[picture p46: page 53]

Figure 49. Output voltage when differential input voltage amplitude is maximum and step-type

Figure 50. Output voltage slew rate

If we apply a step-type signal with very small rise and fall times (ns) to the input, figure 50 shows a slew rate of approximately 3V/µs..

SR = ΔV/ΔT = 5V/1.6µs = 3.125V/µs

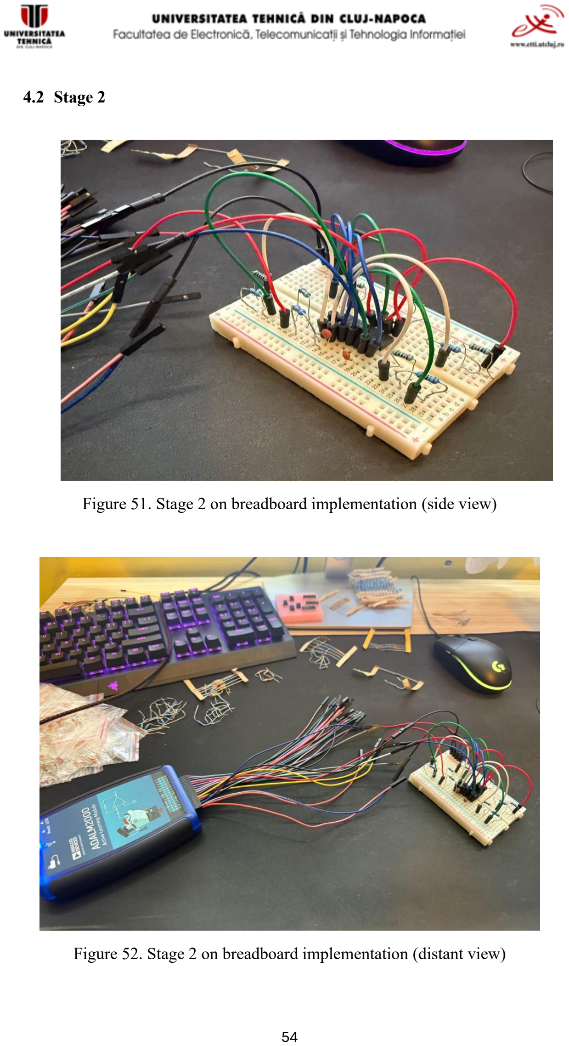
[picture p47: page 54]

### 4.2 Stage 2

Figure 51. Stage 2 on breadboard implementation (side view)

Figure 52. Stage 2 on breadboard implementation (distant view)

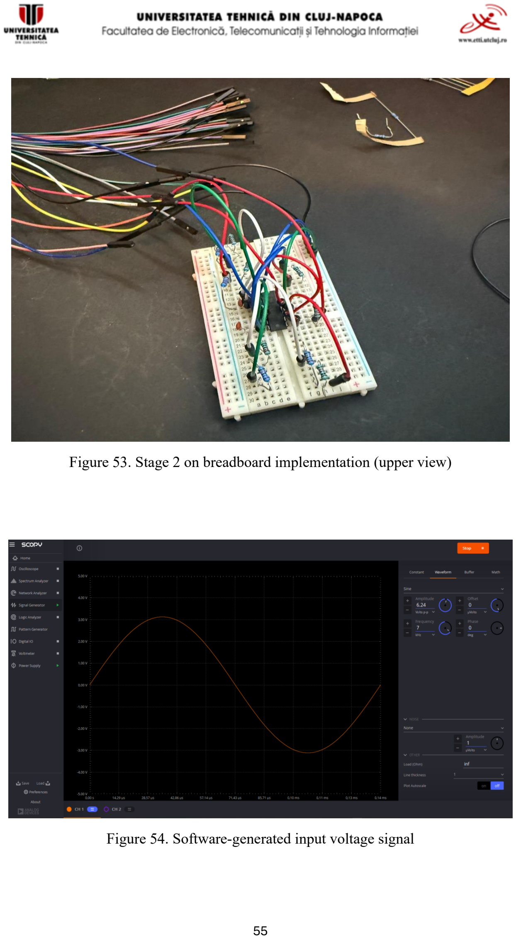
[picture p48: page 55]

Figure 53. Stage 2 on breadboard implementation (upper view)

Figure 54. Software-generated input voltage signal

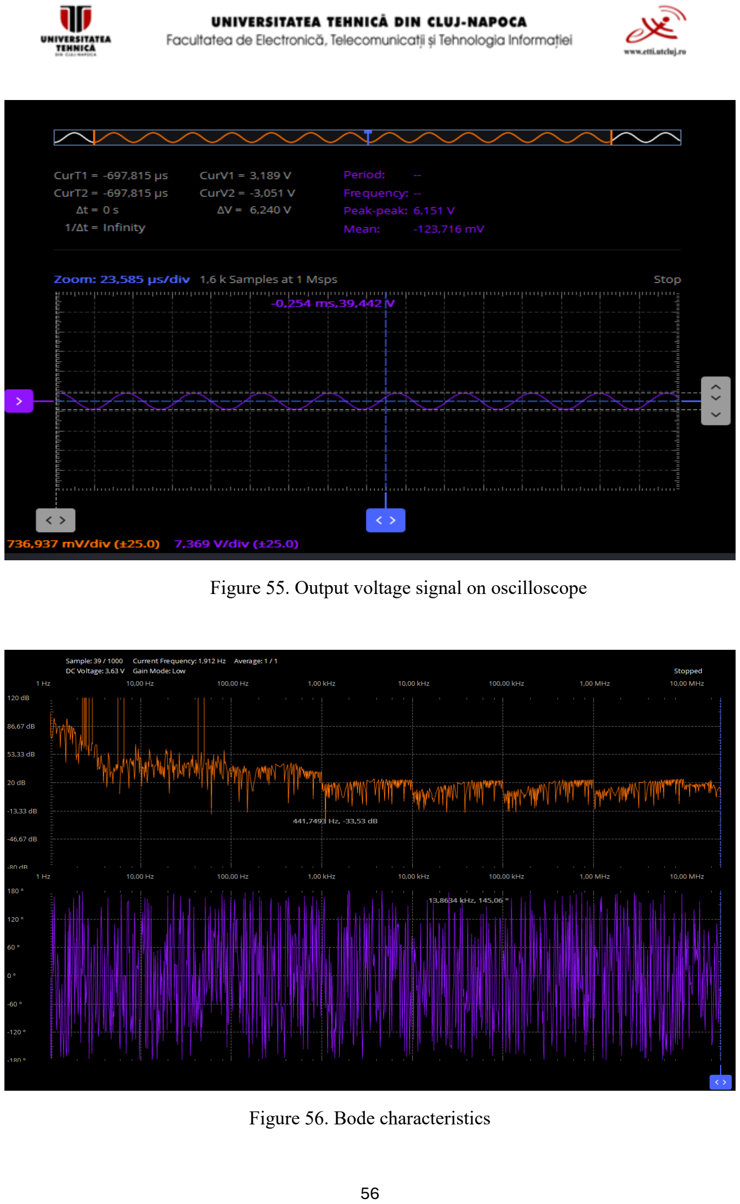
[picture p49: page 56]

Figure 55. Output voltage signal on oscilloscope

Figure 56. Bode characteristics

We cannot practically extract the parameters obtained in LTSpice because we did not obtain a good filter characteristic in Scopy. However, the output signal has approximately the same amplitude as the input signal, so we can deduce the unity gain in the passband.

### 4.3 Stage 3

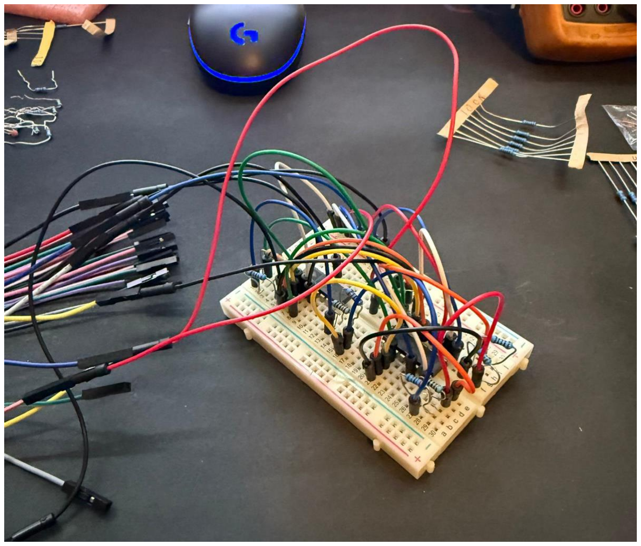
[picture p50: figure]

Figure 57. Stage 3 on breadboard implementation (side view)

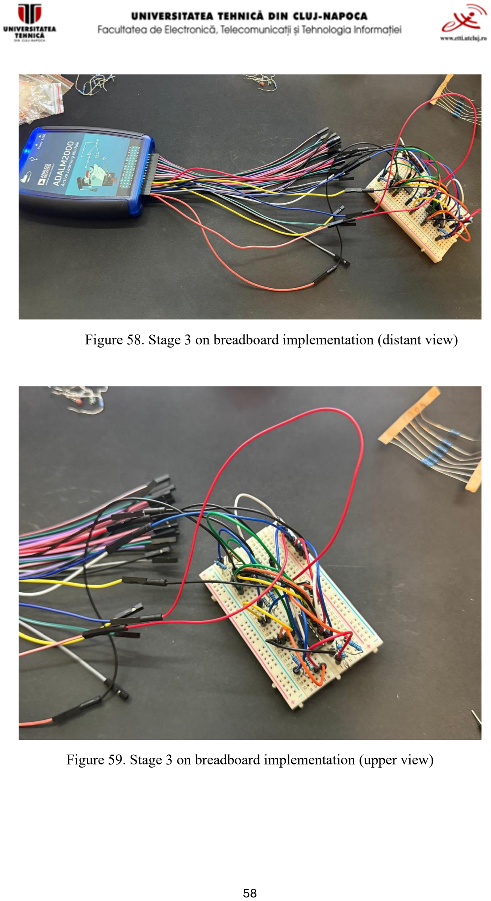
[picture p51: page 58]

Figure 58. Stage 3 on breadboard implementation (distant view)

Figure 59. Stage 3 on breadboard implementation (upper view)

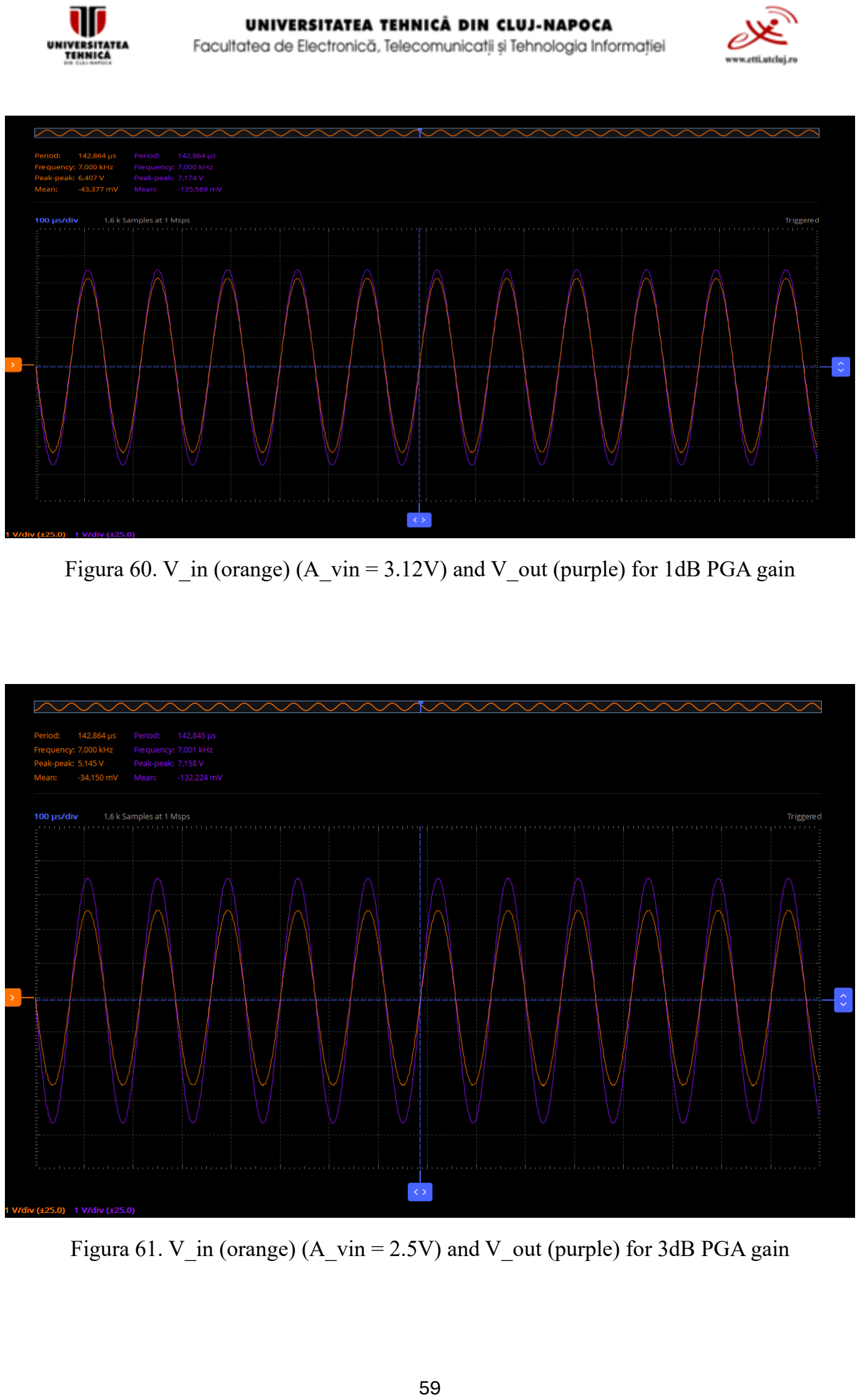
[picture p52: page 59]

Figura 60. V_in (orange) (A_vin = 3.12V) and V_out (purple) for 1dB PGA gain

Figura 61. V_in (orange) (A_vin = 2.5V) and V_out (purple) for 3dB PGA gain

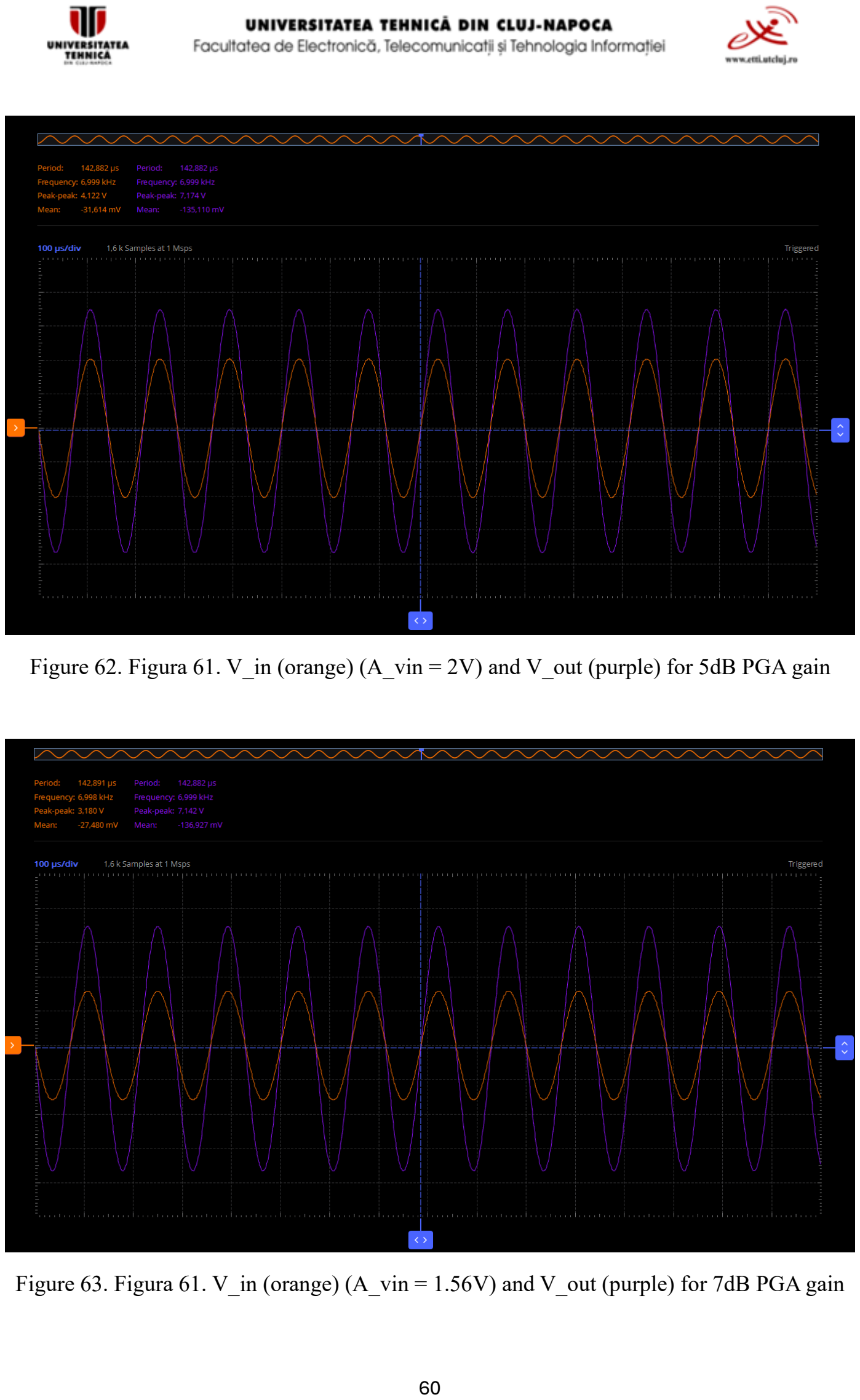
[picture p53: page 60]

Figure 62. Figura 61. V_in (orange) (A_vin = 2V) and V_out (purple) for 5dB PGA gain

Figure 63. Figura 61. V_in (orange) (A_vin = 1.56V) and V_out (purple) for 7dB PGA gain

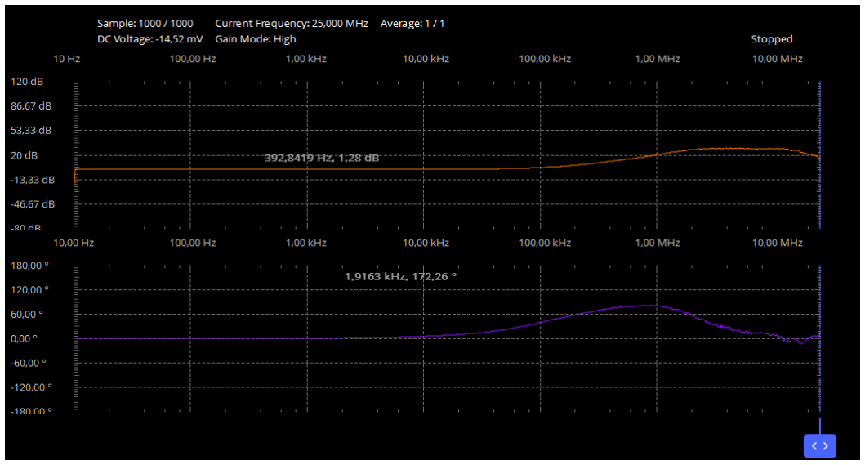
[picture p54: figure]

Figure 64. Bode characteristics

For all 4 gains 1dB, 3dB, 5dB and 7dB the Bode characteristics look identical only that they have the specific gain on the magnitude characteristic. Thus, practically no parameters obtained in LTSpice can be extracted because we also did not obtain a good frequency characteristic in this case.

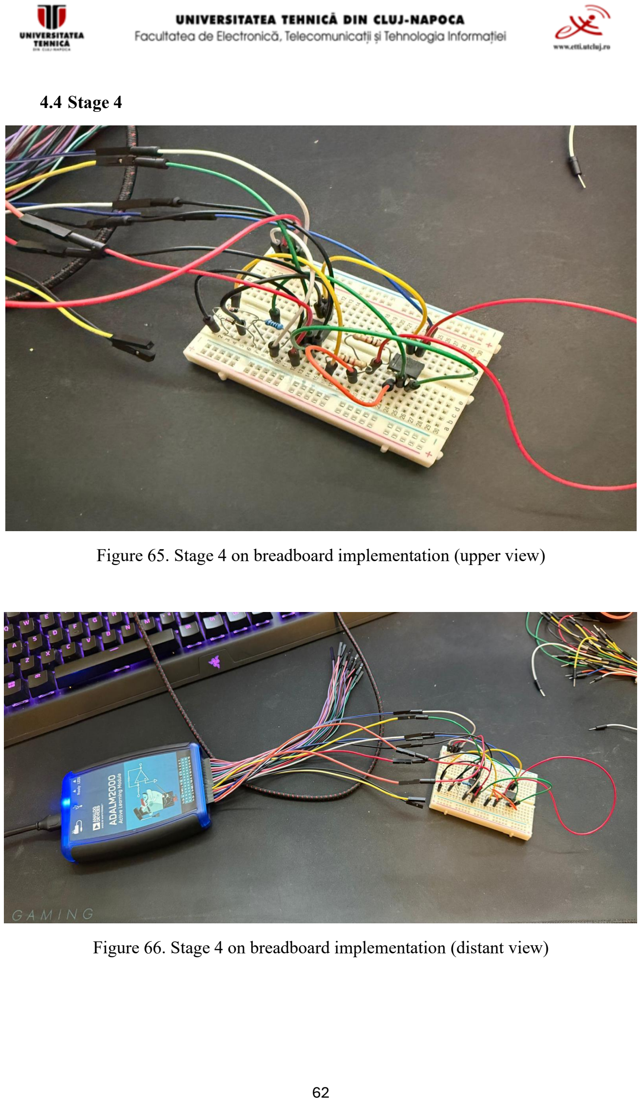
[picture p55: page 62]

### 4.4 Stage 4

Figure 65. Stage 4 on breadboard implementation (upper view)

Figure 66. Stage 4 on breadboard implementation (distant view)

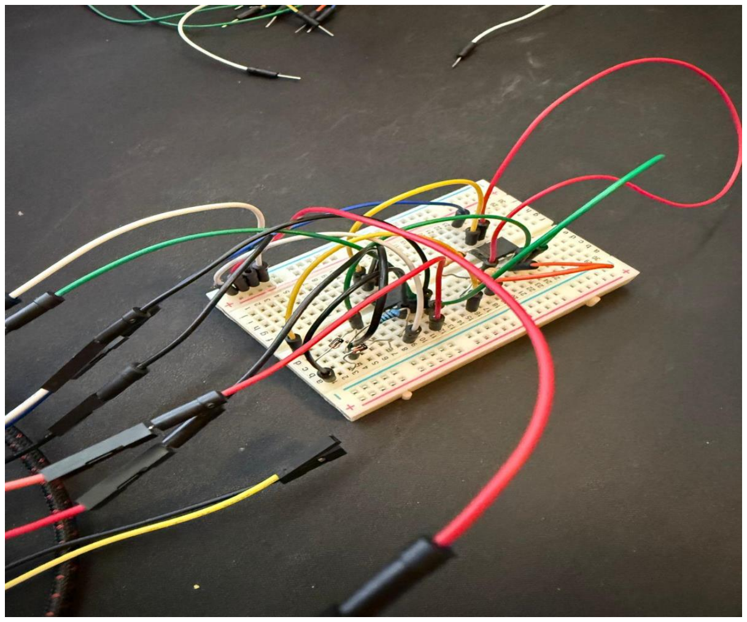
[picture p56: figure]

Figure 67. Stage 4 on breadboard implementation (side view)

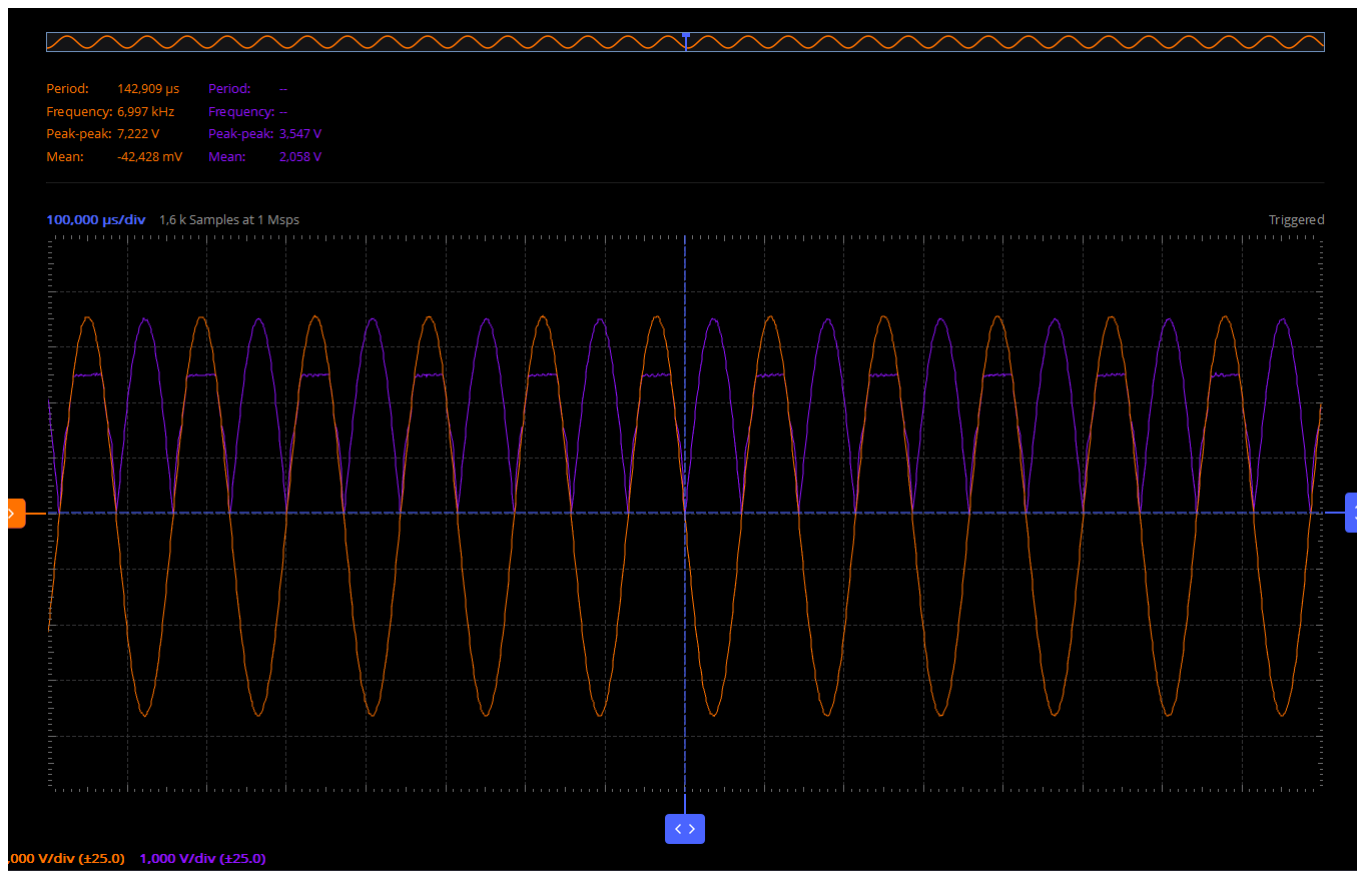
[picture p57: figure]

Figure 68. Full-wave rectifier (input signal – orange, output signal – purple)

According to the simulations in LTSpice, the rectification on the positive alternation is limited to 3.5V amplitude for the input signal and +/-5V supply due to the output voltage swing of OA, which also happens on the practical circuit as seen in figure 68.

## BIBLIOGRAPHY

1. Systems with Analog Integrate Circuits Courses, prof. dr. ing. Marius Neag
2. Datasheet MAX4617
https://www.analog.com/media/en/technical-documentation/data-sheets/max4617-max4619.pdf (https://www.analog.com/media/en/technical-documentation/data-sheets/max4617-max4619.pdf)
3. Datasheet OP482
https://www.analog.com/media/en/technical-documentation/data-sheets/op282_482.pdf (https://www.analog.com/media/en/technical-documentation/data-sheets/op282_482.pdf)
4. Datasheet LT1357
https://www.analog.com/media/en/technical-documentation/data-sheets/1357fa.pdf
5. Resistor finder
https://mustcalculate.com/electronics/resistorfinder.php?r=1.6k&es=E6#google_vigne tte (https://mustcalculate.com/electronics/resistorfinder.php?r=1.6k&es=E6#google_vignette)
