sebastian-silaghi/Analog-Interface-for-ADC-input/Simulations/Circuit.asc

AO1: ADA4627
AO2: ADA4627
AO3: ADA4627
AO4: ADA4627
AO5: ADA4627
AO6: ADA4627
AO7: ADA4627
AO8: ADA4627
AO9: ADA4627
C1: cap; 100p
C2: cap; 100p
C3: cap; 10p
D1: diode; 1N4148
D2: diode; 1N4148
R1: res; 2.5k
R2: res; 2.5k
R3: res; 2.2k
R4: res; 2.2k
R5: res; 2.2k
R6: res; 2.2k
R7: res; 230k
R8: res; 230k
R9: res; 230k
R10: res; 10k
R11: res; 10k
R12: res; 230k
R13: res; 10k
R14: res; 1.6k
R15: res; 1.8k
R16: res; 1.8k
R17: res; 17k
R18: res; 100
R19: res; 1k
R20: res; 1k
RG: res; 1k
SW1: ADG1311
SW2: ADG1311
SW3: ADG1311
SW4: ADG1311
V1: voltage; SINE(0 -260m 7k 0 0 0); AC 0
V2: voltage; SINE(0 260m 7k 0 0 0); AC 1
V3: voltage; -15V
V4: voltage; 15V
V5: voltage; 585µV
Named nets: 0, VB, VA, +VCC, -VCC, VREF, VO1, VO2, VO3, VO4, VOBP, VOLP, VO5, VO6, VOAO8
;R1=R2
;R3=R4
;R5=R6
.ac dec 100 1 100MEG
.tran 0 2m
.op
;A_min=261mV (130.5mV diferential)
;A_max=520mV (260mV diferential)
;f_in_max=f_centrala_BPF=7kHz
;din analiza .op compensam Vos la VO3 cu Vref = 585uV (vin = 0V)
.four 7k 10 V(vo3)
;THD<1% la VO3 pt ambele amplitudini si f_max
;Slew-Rate: PULSE(0 260m 5m 1n 1n 15m)
            ;.tran -> V(vo3)
            ;cursoare la 10% si 90% din semnal
            ;slope (fara e+06) -> SR
;H0=R12/R7
;w0=1/sqrt(R9*R12*C1*C2)
;Q=R8*sqrt((C1/C2)*(1/(R9*R12)))
 
;R12=R9, C1=C2 => w0=1/(R9*C1)
                  ;Q=R8/R9
                  ;f0=BW*Q
;Gain = 6 [V/V] = 15.56dB
;f0_FTJ=8.8kHz
;f_centrala_FTB=7kHz
;Bandwidth: 6MHz
;pentru liniaritate etaj 1
.four 7k 10 V(vo4)
;pentru liniaritate etaj 2 -> ampl_out=ampl_in*gain_H0 la f_centrala_BPF
;BW_BPF=fs(Amax-3dB)-fi(Amax-3dB)=11.2k-4.3k=~7kHz=f_centrala_BPF
;BW_LPF=f(Amax-3dB)=8.8kHz
;(usor overshoot pe caracteristici, sistem subamortizat xi=1/2Q=0.5)
;f_FTJ(-90grade)=f0_FTB(-180grade)=7kHz
;H0_FTJ(-90grade)=H0_FTB(-180grade)=15.56dB
;H0=15.56dB (nu 0dB precum in calcul), dar e bine, deoarece
;aceasta este practic Aetaj1[dB]+Aetaj2[dB]=15.56dB+0dB, deci castigul filtrului este 0dB
;Rin=R7 >= 1kohm
.four 7k 10 V(vo5)
;liniaritate: fara distorsiuni (THD < 1%)    ampl_in_min * PGA_max_gain la fin_max   
                                                      ;ampl_in_max * PGA_min_gain la fin_max
;verificare banda_PGA>banda filtru (7kHz):   .ac -> plot VO5/VO4
          ;Gain e in functie de active switch
          ;Banda_PGA = Gain[dB]-3dB
;Rin_min=R13 >= 1.5kohm
;verificare banda_PGA>banda_filtru pt fiecare gain PGA
;verificare castig filtru H0 -> .ac -> plot V(vo4)/V(vo3)
;f_centrala_BPF=f unde castig BPF e maxim
;f0_sup(max)_FTB=11.2kHz
;f0_inf(min)_FTB=4.3kHz
;SW=ON daca IN=GND
;SW=OFF daca IN=VCC
;A_Vin=1.56V cu SW1 ON
;A_Vin=3.12V cu SW4 ON
