sebastian-silaghi/Analog-Interface-for-ADC-input/Simulations/CMRR.asc

AO1: ADA4627
AO2: ADA4627
AO3: ADA4627
AO4: ADA4627
AO5: ADA4627
AO6: ADA4627
R1: res; 2.5k
R2: res; 2.5k
R3: res; 2.2k
R4: res; 2.2k
R5: res; 2.2k
R6: res; 2.2k
R7: res; 2.5k
R8: res; 2.5k
R9: res; 2.2k
R10: res; 2.2k
R11: res; 2.2k
R12: res; 2.2k
RG1: res; 1k
RG: res; 1k
V1: voltage; SINE(0 -130.5m 7k 0 0 0); AC 0
V2: voltage; SINE(0 130.5m 7k 0 0 0); AC 1
V3: voltage; -15V
V4: voltage; 585µV
V5: voltage; 15V
Vicm: voltage; 0V; AC 1
Named nets: VB, VA, -VCC, +VCC, VREF, Vo1d, Vo2d, Vod, 0, Vo1cm, Vo2cm, Vocm
.ac dec 100 1 100MEG
;CMRR=Vod/Vocm
