sebastian-silaghi/Analog-Interface-for-ADC-input/Simulations/FTT.asc

AO1: ADA4627
AO2: ADA4627
AO3: ADA4627
C1: cap; 100p
C2: cap; 100p
R1: res; 230k
R2: res; 230k
R3: res; 230k
R4: res; 10k
R5: res; 10k
R6: res; 230k
V1: voltage; -15V
V2: voltage; 15V
V3: voltage; SINE(0 1.56 7k 0 0 0); AC 1
Named nets: 0, -VCC, +VCC, VO4, VOBP, VOLP, VO3
.ac dec 100 1 100MEG
.tran 0 2m
.four 7k 10 V(vo4)
.op
;Vo3=3.12V
;Vo3=1.56V
