sebastian-silaghi/Analog-Interface-for-ADC-input/Simulations/FWR.asc

AO1: ADA4627
AO2: ADA4627
C3: cap; 10p
D1: diode; 1N4148
D2: diode; 1N4148
R18: res; 100
R19: res; 1k
R20: res; 1k
V1: voltage; -15V
V2: voltage; 15V
V3: voltage; SINE(0 3.5 7k 0 0 0); AC 1
Named nets: 0, +VCC, -VCC, VO5, VO6, VOAO8
.ac dec 100 1 100MEG
.tran 0 2m
.op
.dc V3 -15 15 1
