sebastian-silaghi/Analog-Interface-for-ADC-input/Simulations/PGA.asc

AO2: ADA4627
R6: res; 10k
R7: res; 1.6k
R8: res; 1.8k
R9: res; 1.8k
R10: res; 17k
SW1: ADG1311
SW2: ADG1311
SW3: ADG1311
SW4: ADG1311
V1: voltage; SINE(0 -3.12 7k); AC 1
V2: voltage; -15V
V3: voltage; 15V
Named nets: 0, +VCC, -VCC, VO4, VO5
;SW=ON daca IN=GND
;SW=OFF daca IN=VCC
;A_Vin=-1.56V cu SW1 ON
;A_Vin=-3.12V cu SW4 ON
.ac dec 100 1 100MEG
.tran 0 2m
.op
.four 7k 10 V(vo5)
