sebastian-silaghi/Analog-Interface-for-ADC-input/Simulations/SR.asc

AO1: ADA4627
AO2: ADA4627
AO3: ADA4627
R1: res; 2.5k
R2: res; 2.5k
R3: res; 2.2k
R4: res; 2.2k
R5: res; 2.2k
R6: res; 2.2k
RG1: res; 1k
V1: voltage; PULSE(0 -130.5m 5m 1n 1n 15m); AC 0
V2: voltage; PULSE(0 130.5m 5m 1n 1n 15m); AC 1
V3: voltage; -15V
V4: voltage; 585µV
V5: voltage; 15V
Named nets: VB, VA, -VCC, +VCC, VREF, VO1, VO2, VO3, 0
.ac dec 100 1 100MEG
.tran 0 30m
.op
.four 7k 10 V(vo3)
